plotneishestvo/ZanGei/docs/datasheets/README.md

# Component datasheets

These are unmodified manufacturer documents copied from the project's existing reference collection so the active BBD symbol links do not depend on unpublished notes.

| Local file | Document | Public reference |
|---|---|---|
| [V3208_DATASHEETS.pdf](V3208_DATASHEETS.pdf) | Coolaudio V3208D/V3208SD, V1.1; the build uses the V3208D DIP8 variant | [Supplier reference page](https://cabintechglobal.com/v3208d) |
| [coolaudio-v3205.pdf](coolaudio-v3205.pdf) | Coolaudio V3205SD, V1.0; special spaced eight-lead package | [Public document mirror](https://aionfx.com/app/files/datasheets/coolaudio-v3205.pdf) |

Vendor documents retain their own copyright and notices. The project's MIT declaration does not relicense them or imply manufacturer endorsement. Check applicable redistribution terms before redistributing these documents separately.

Other relevant specifications are linked rather than duplicated:

- [TI CD4046B](https://www.ti.com/product/CD4046B)
- [Microchip TC4428A family](https://www.microchip.com/en-us/product/TC4428A)
- [Nidec CT-6 trimmers](https://www.nidec-components.com/e/catalog/trimmer/ct-6.pdf)
- [Samtec TSW headers](https://suddendocs.samtec.com/catalog_english/tsw_th.pdf) and [SSW sockets](https://suddendocs.samtec.com/catalog_english/ssw_th.pdf)

Select the exact purchased suffix/package; family compatibility does not establish pin numbering or mechanical fit. Use the native schematic and current BOM for the implemented choices.
