plotneishestvo/ZanGei/docs/LICENSING.md

# Licensing

## Project-authored files and hardware designs

The [MIT License](../LICENSE) applies to project-authored schematics, PCB layouts, custom symbols and footprints, mechanical/panel designs and models, scripts, BOM data and documentation, except where a file carries a different notice.

For project-authored hardware designs, permission includes using and modifying the designs to manufacture, use, distribute and sell physical hardware. Retain the applicable copyright and licence notices when distributing the design files or substantial portions of them. The project does not require publication of your modifications.

Copyright notices for the project-authored material include:

- Copyright (c) 2026 Pavel Plotnikov
- Copyright (c) 2026 ZanGei contributors

The standard MIT licence text is retained unchanged in `LICENSE`. This scope statement does not remove any MIT conditions or disclaimers. MIT is not a hardware-specific patent licence, safety certification or guarantee that third-party rights have been cleared.

## Third-party material

The project licence does not relicense third-party material, including:

- Manufacturer datasheets in `docs/datasheets/` and linked documents; see the [datasheet notes](datasheets/README.md).
- The Texas Instruments TL072 SPICE model in `simulation/models/TL072_TI.lib`, which retains its original notices.
- Assets derived from KiCad libraries, which remain subject to their applicable library licence and exceptions.

Respect the notices and terms supplied with each third-party asset. The design is independently developed and inspired by the Erica Synths EDU BBD project; that attribution does not imply endorsement or grant rights to its separate materials.

## Prototype limitations

The supplied design is an unqualified prototype, not a proven kit. Manufacturing, assembly and operation are at the builder's risk. Read the [build and power precautions](BUILD.md); the licence does not replace electrical, mechanical or regulatory assessment.
