plotneishestvo/ZanGei/mechanical/Panel_Front.png

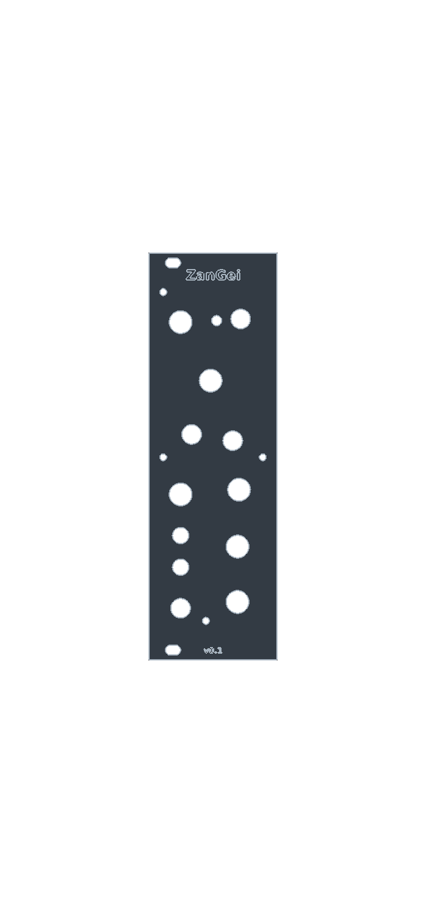
mechanical/Panel_Front.png
