plotneishestvo/ZanGei/mechanical/Panel_Preview.png

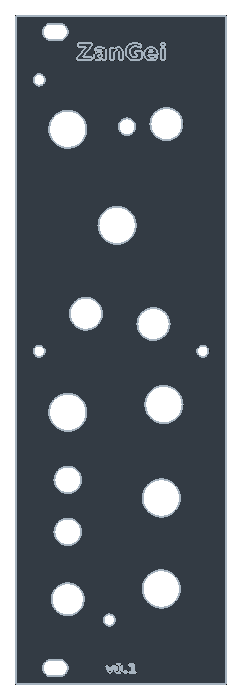
mechanical/Panel_Preview.png
