plotneishestvo/ZanGei/mechanical/Power_Marking.png

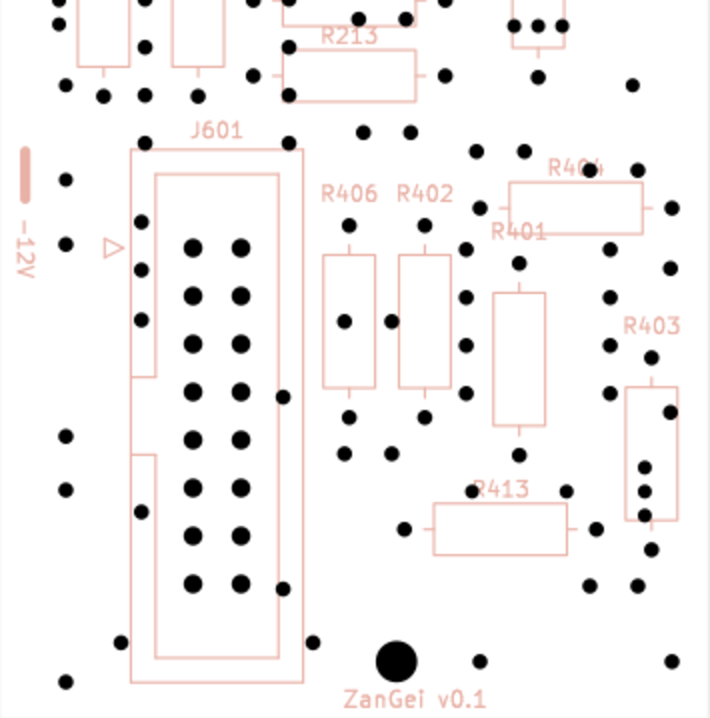
mechanical/Power_Marking.png
