plotneishestvo/ZanGei/schematics/buffer_schematic.png

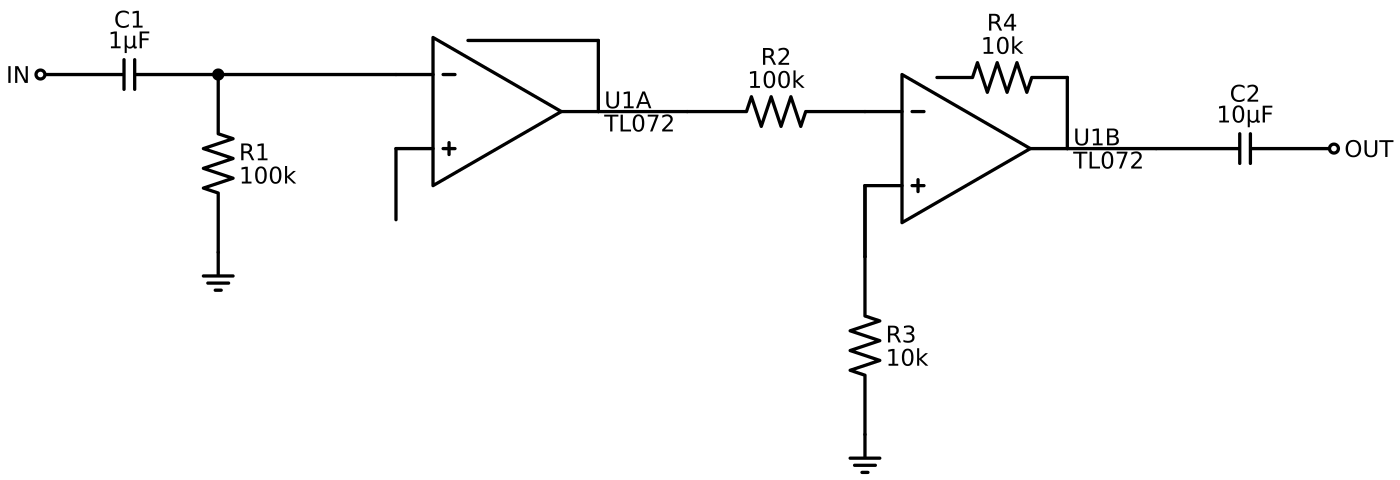
schematics/buffer_schematic.png
