plotneishestvo/ZanGei/schematics/routing/Traces_Review.png

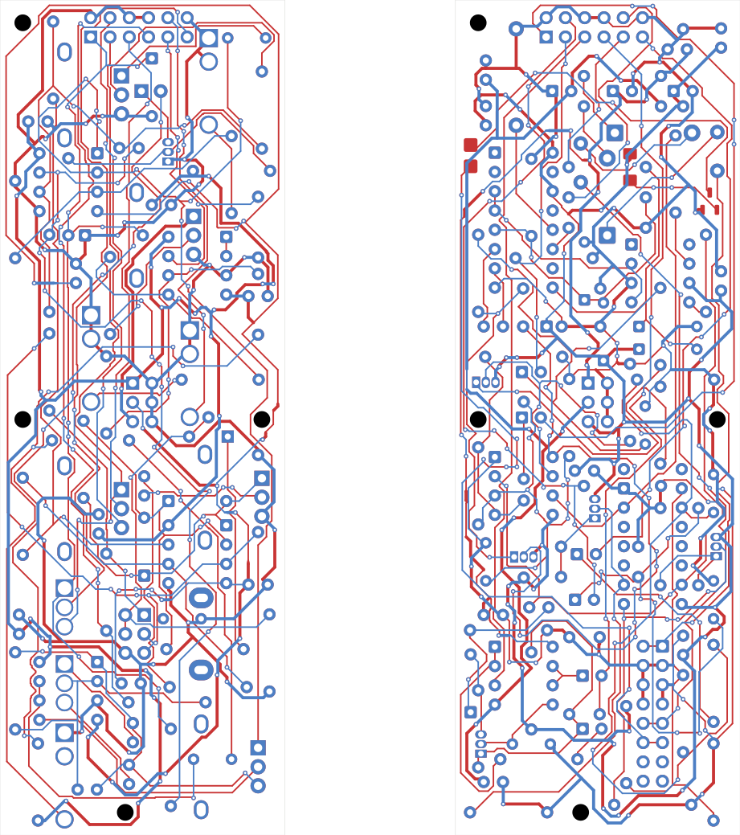
schematics/routing/Traces_Review.png
