plotneishestvo/ZanGei/bom/v0.1/BOM_GROUPED.csv

Group_ID | References | Schematic_values_exact | Quantity_per_module | Selected_part | Footprints | Product_URL | Notes
1N4148 | D401, D402, D403, D702, D703 | 1N4148 ; 1N4148, A at gate | 5 | 1N4148 (= 1N914) | Diode_THT:D_DO-35_SOD27_P7.62mm_Horizontal | https://en.uraltone.com/catalogsearch/result/?q=183-1N4148 | DO-35 axial; observe diode polarity, including D401 anode at gate.
1N5817 | D601, D602 | 1N5817 | 2 | 1N5817 Schottky diode 20V, 1A | Diode_THT:D_DO-41_SOD81_P10.16mm_Horizontal | https://en.uraltone.com/catalogsearch/result/?q=183-1N5817 | 20 V, 1 A Schottky; observe polarity.
2N3904 | Q701 | 2N3904 | 1 | 2N3904BU | Package_TO_SOT_THT:TO-92_Inline | https://www.digikey.com/en/products/detail/onsemi/2N3904BU/1413 | onsemi TO-92; verify received pin order against footprint.
2N5457 | Q401 | 2N5457 S&H switch | 1 | 2N5457 J-FET N-channel Fairchild NOS USA | Package_TO_SOT_THT:TO-92_Inline | https://en.uraltone.com/catalogsearch/result/?q=181-2N5457-FAIR | Selected Fairchild NOS part: physical pins 1=D, 2=S, 3=G; other manufacturers may differ.
2N7000 | Q101, Q102, Q201, Q202 | 2N7000 | 4 | 2N7000 Transistor N-MOSFET, 60V, 200mA, TO-92 | Package_TO_SOT_THT:TO-92_Inline | https://en.uraltone.com/catalogsearch/result/?q=181-2N7000 | 60 V, 200 mA TO-92; verify received pin order.
AO3401A | Q601 | AO3401A | 1 | AO3401A | Package_TO_SOT_SMD:SOT-23-3 | https://www.digikey.com/en/products/detail/alpha-omega-semiconductor-inc/AO3401A/1855773 | P-channel SOT-23; SMD.
BAT85 | D301, D302, D303, D304 | BAT85 | 4 | BAT85S-TAP | Diode_THT:D_DO-34_SOD68_P7.62mm_Horizontal | https://www.digikey.com/en/products/detail/vishay-general-semiconductor-diodes-division/BAT85S-TAP/3104127 | Vishay BAT85S-TAP, 30 V / 200 mA, DO-35; maximum capsule 3.9 x 1.7 mm; P7.62 mm. Body-envelope screening is not full assembly qualification.
CD4046BE | U301 | CD4046BE | 1 | CD4046BE CMOS digital Phase-Locked Loop DIL16 | Package_DIP:DIP-16_W7.62mm_Socket | https://en.uraltone.com/catalogsearch/result/?q=184-4046BE | Through-hole DIL16.
C_10 | C801 | 10p | 1 | C315C100J5G5TA | Zangei:C_Radial_KEMET_C315_P2.54_Body3.81x5.0 | https://www.digikey.com/en/products/detail/kemet/C315C100J5G5TA/6562319 | 10 pF C0G, 5%, 50 V; P2.54 mm.
C_10000 | C405 | 10n | 1 | R82EC2100AA50J | Capacitor_THT:C_Rect_L7.2mm_W2.5mm_P5.00mm | https://www.digikey.com/en/products/detail/kemet/R82EC2100AA50J/2571307 | 10 nF polyester film, 5%, 100 V; P5 mm; nominal body 7.2 x 2.5 mm.
C_100000 | C104, C204, C302, C304, C406, C407, C408, C409, C410, C501, C502, C602, C604, C606, C703, C704, C805, C806 | 100n ; 100nF | 18 | C315C104K5R5TA | Zangei:C_KEMET_C315C104_P2.54_L3.81_W2.54 | https://www.digikey.com/en/products/detail/kemet/C315C104K5R5TA/12701330 | 100 nF X7R, 50 V; compact P2.54 mm body required.
C_1000000 | C701, C804 | 1u film ; 1u film DC BLOCK | 2 | R82EC4100AA70J | Capacitor_THT:C_Rect_L7.2mm_W6.0mm_P5.00mm | https://www.digikey.com/en/products/detail/kemet/R82EC4100AA70J/9685242 | 1 uF polyester film, 5%, 100 V; P5 mm; nominal body 7.2 x 6 mm, seated height 11.1 mm. Do not substitute ceramic.
C_15000 | C403 | 15nF hold | 1 | KEMET 15nF (0.015uF) / 400V polyester film capacitor, radial | Capacitor_THT:C_Rect_L7.2mm_W4.5mm_P5.00mm | https://en.uraltone.com/catalogsearch/result/?q=545-MC5-15N/400V | 15 nF / 400 V polyester film, radial; check actual body and lead seating.
C_220 | C301, C402, C803 | 220p DARK ; 220pF | 3 | C315C221J5G5TA | Zangei:C_Radial_KEMET_C315_P2.54_Body3.81x5.0 | https://www.digikey.com/en/products/detail/kemet/C315C221J5G5TA/6562497 | 220 pF C0G, 5%, 50 V; P2.54 mm.
C_33000 | C102, C202 | 33nF | 2 | R82EC2330AA50J | Capacitor_THT:C_Rect_L7.2mm_W2.5mm_P5.00mm | https://www.digikey.com/en/products/detail/kemet/R82EC2330AA50J/2571333 | 33 nF polyester film, 5%, 100 V; P5 mm; nominal body 7.2 x 2.5 mm.
C_3300000 | C101, C106, C201, C206, C401 | 3.3uF | 5 | Nichicon 3.3uF / 50V FW audio electrolytic capacitor, radial | Capacitor_THT:CP_Radial_D5.0mm_P2.50mm | https://en.uraltone.com/catalogsearch/result/?q=518-003-1H5X11UFW | 3.3 uF / 50 V Nichicon FW; nominal D5 x H11 mm, P2.5 mm; polarised.
C_47 | C702 | 47p | 1 | C315C470J5G5TA | Zangei:C_Radial_KEMET_C315_P2.54_Body3.81x5.0 | https://www.digikey.com/en/products/detail/kemet/C315C470J5G5TA/3725986 | 47 pF C0G, 5%, 50 V; P2.54 mm.
C_4700 | C105, C205 | 4.7nF | 2 | R82EC1470AA50J | Capacitor_THT:C_Rect_L7.2mm_W2.5mm_P5.00mm | https://www.digikey.com/en/products/detail/kemet/R82EC1470AA50J/2571340 | 4.7 nF polyester film, 5%, 100 V; P5 mm; nominal body 7.2 x 2.5 mm.
C_4700000 | C305 | 4.7u 16V | 1 | Panasonic 4.7uF 50V 5x11mm; UralTone518-P-4.7-50 | Zangei:CP_Radial_D5_H11_P2.00_NoModel | https://en.uraltone.com/4-7uf-50v-panasonic-5x11mm-electrolytic-capacitor.html | 4.7 uF / 50 V Panasonic; nominal D5 x H11 mm, P2.0 mm; polarised.
C_47000000 | C404, C601, C603, C607 | 47u / 16V ; 47u / 25V ; 47uF | 4 | Nichicon 47uF / 50V electrolytic capacitor, radial | Capacitor_THT:CP_Radial_D6.3mm_P2.50mm | https://en.uraltone.com/catalogsearch/result/?q=518-047-1H6X11UFW | 47 uF / 50 V Nichicon FW; nominal D6.3 x H11 mm, P2.5 mm; polarised.
C_68 | C802 | 68p SOFT | 1 | C315C680J5G5TA | Zangei:C_Radial_KEMET_C315_P2.54_Body3.81x5.0 | https://www.digikey.com/en/products/detail/kemet/C315C680J5G5TA/12700720 | 68 pF C0G, 5%, 50 V; P2.54 mm.
FERRITE | FB601 | DCR <=0.1R; >=0.5A | 1 | BLM31PG121SN1L | Zangei:Ferrite_Murata_BLM31PG_Pads1.5x1.8_Gap2.0 | https://www.digikey.com/en/products/detail/murata-electronics/BLM31PG121SN1L/584265 | 120 ohm at 100 MHz, DCR <=0.1 ohm, current >=0.5 A; 1206 SMD.
J601 | J601 | EURORACK 2x8 KEYED - BUS +5V | 1 | Exploding Shed 100702 — 2x8 shrouded header | Connector_IDC:IDC-Header_2x08_P2.54mm_Vertical | https://www.exploding-shed.com/2x8-shrouded-header/100702 | Vertical keyed/shrouded 2x8, 2.54 mm; verify actual housing seating, pin 1 and cable polarity.
J602 | J602 | CORE POWER | 1 | Samtec TSW-120-15-G-D cut to 2x3 | Connector_PinHeader_2.54mm:PinHeader_2x03_P2.54mm_Vertical | https://www.digikey.com/en/products/detail/samtec-inc/TSW-120-15-G-D/2686005 | One 2x3 section cut from ONE shared 2x20 TSW-120-15-G-D strip per module; that same strip also supplies J604. Keep 13.21 mm mating posts intact.
J603 | J603 | CONTROL POWER | 1 | SSW-103-01-G-D | Connector_PinSocket_2.54mm:PinSocket_2x03_P2.54mm_Vertical | https://www.digikey.com/en/products/detail/samtec-inc/SSW-103-01-G-D/1112055 | 2x3, 2.54 mm; 8.51 mm socket body. Mate with J602; dry-fit at 20 mm PCB-surface gap.
J604 | J604 | CORE SIGNALS | 1 | Samtec TSW-120-15-G-D cut to 2x6 | Connector_PinHeader_2.54mm:PinHeader_2x06_P2.54mm_Vertical | https://www.digikey.com/en/products/detail/samtec-inc/TSW-120-15-G-D/2686005 | One 2x6 section from the SAME 2x20 strip as J602; no second full strip required. Keep 13.21 mm mating posts intact.
J605 | J605 | CONTROL SIGNALS | 1 | SSW-106-01-G-D | Connector_PinSocket_2.54mm:PinSocket_2x06_P2.54mm_Vertical | https://www.digikey.com/en/products/detail/samtec-inc/SSW-106-01-G-D/1112052 | 2x6, 2.54 mm; 8.51 mm socket body. Mate with J604; dry-fit at 20 mm PCB-surface gap.
JACK | J301, J302, J701, J702 | AUDIO IN ; AUDIO OUT ; INHIBIT CV ; TIME CV | 4 | Qingpu WQP518MA, Exploding Shed 100515 | Zangei:Jack_WQP518MA_PJ398SM_Numeric | https://www.exploding-shed.com/thonkiconn-mono-wqp518ma/100515 | Vertical switched mono PCB jack; effective body height 10 mm, M6x0.5 thread; four separate nuts required. Not WQP518MA-BM.
LED | D701 | RED CLIP | 1 | WP3A8ID | LED_THT:LED_D3.0mm | https://www.digikey.com/en/products/detail/kingbright/WP3A8ID/1747618 | Red diffused 3 mm LED; set panel height before trimming leads.
PTC_RADIAL | F601, F602 | 200mA HOLD, >=30V | 2 | MF-R020-2 | Zangei:PTC_Bourns_MF-R020_P5.10 | https://www.digikey.com/en/products/detail/bourns-inc/MF-R020-2/2561642 | 200 mA hold / 400 mA trip, 60 V radial PTC; D7.4 x T3.1 mm, P5.1 mm, maximum seated height 12.7 mm. Hold current is not an instantaneous limit.
PTC_SMD | F603 | 1206L025/24 250mA HOLD | 1 | 1206L025/24YR | Zangei:PTC_Littelfuse_1206L_ManufacturerLands | https://www.digikey.com/en/products/detail/littelfuse-inc/1206L025-24YR/14320017 | 250 mA hold, 24 V; 1206 SMD with selected Littelfuse land pattern.
RV_DUAL50K | RV402 | 2x50k LIN CHARACTER | 1 | Alpha RD902F dual B50K, SKU100895-B50K | Potentiometer_THT:Potentiometer_Alpha_RD902F-40-00D_Dual_Vertical | https://www.exploding-shed.com/alpha-rd902f-dual-vertical/100895-B50K | Dual linear 50k, 6.35 mm round shaft; exact variant seating/drill fit requires comparison. R414/R415 are exact 50k shunts.
RV_SINGLE10000 | RV404, RV801 | 10k LIN AMOUNT ; 10k LIN DRY / WET | 2 | UT RD901F B10K T18 shaft,624-UT-RD901F-40-15K-B10K | Zangei:Potentiometer_RV09_ExplodingShed_101018 | https://en.uraltone.com/ut-rd901f-40-15k-series-10k-lin-9mm-vertical-potentiometer.html | Single linear 10k; 6 mm T18 knurled shaft. Drawing shows 2.5 mm pitch versus catalogue 2.54 mm; dry-fit common panel plane.
RV_SINGLE100000 | RV301, RV401, RV701 | 100k LIN INPUT ; 100k LIN wet blend (provisional) ; 100k TIME LIN | 3 | RV9 B100K linear D-shaft, SKU101018-B100K | Zangei:Potentiometer_RV09_ExplodingShed_101018 | https://www.exploding-shed.com/b100k-potentiometer-rv9-d-shaft/101018-B100K | Single linear 100k; 6 mm D shaft; includes nut/washer. Verify common panel seating.
RV_TRIM10K | RV403 | 10k DRIVE TRIM | 1 | CT-6EP103 | Zangei:Trimmer_Nidec_CT-6EP | https://www.digikey.fi/en/products/detail/nidec-components/CT-6EP103/738304 | Nidec 10k top-adjust cermet; 2.5 mm triangular pitch; nominal 7 x 7 x 5.8 mm, reserved envelope 7.3 x 7.3 x 6.1 mm.
R_100 | R413, R708 | 100 ; 100R | 2 | 100 ohm metal-film 0.25W <=1%, axial | Zangei:R_Axial_L6.8mm_D2.5mm_P10.16mm |  | Axial metal-film, 0.25 W, <=1%; body <=6.8 x 2.5 mm; form leads to P10.16 mm.
R_1000 | R101, R201, R603, R701, R716, R804 | 1k ; 1k / 0.125W BLEED ; 1k OUTPUT ISOLATION | 6 | 1000 ohm metal-film 0.25W <=1%, axial | Zangei:R_Axial_L6.8mm_D2.5mm_P10.16mm |  | Axial metal-film, 0.25 W, <=1%; body <=6.8 x 2.5 mm; form leads to P10.16 mm.
R_10000 | R110, R111, R112, R113, R210, R211, R212, R213, R715 | 10k ; 10k LED | 9 | 10000 ohm metal-film 0.25W <=1%, axial | Zangei:R_Axial_L6.8mm_D2.5mm_P10.16mm |  | Axial metal-film, 0.25 W, <=1%; body <=6.8 x 2.5 mm; form leads to P10.16 mm.
R_100000 | R102, R114, R202, R214, R304, R306, R401, R402, R403, R406, R411, R501, R705, R805 | 100k ; 100k LOOP RANGE | 14 | MFR-25FBF52-100K | Zangei:R_Axial_L6.8mm_D2.5mm_P10.16mm | https://www.digikey.com/en/products/detail/yageo/MFR-25FBF52-100K/13473 | Exact 100000 ohm, 1%; axial P10.16 mm. Preserve selected part and verify its rated power/body against manufacturer data.
R_1000000 | R305, R408, R704, R707 | 1M ; 1M INPUT BIAS | 4 | 1000000 ohm metal-film 0.25W <=1%, axial | Zangei:R_Axial_L6.8mm_D2.5mm_P10.16mm |  | Axial metal-film, 0.25 W, <=1%; body <=6.8 x 2.5 mm; form leads to P10.16 mm.
R_1200 | R407 | 1k2 | 1 | MFR-25FTE52-1K2 | Zangei:R_Axial_L6.8mm_D2.5mm_P10.16mm | https://www.digikey.com/en/products/detail/yageo/MFR-25FTE52-1K2/9139850 | Exact 1200 ohm, 1%; axial P10.16 mm. Preserve selected part and verify its rated power/body against manufacturer data.
R_120000 | R103, R203 | 120k | 2 | MFR-25FBF52-120K | Zangei:R_Axial_L6.8mm_D2.5mm_P10.16mm | https://www.digikey.com/en/products/detail/yageo/MFR-25FBF52-120K/9138049 | Exact 120000 ohm, 1%; axial P10.16 mm. Preserve selected part and verify its rated power/body against manufacturer data.
R_20000 | R503, R801 | 20k | 2 | 20000 ohm metal-film 0.25W <=1%, axial | Zangei:R_Axial_L6.8mm_D2.5mm_P10.16mm |  | Axial metal-film, 0.25 W, <=1%; body <=6.8 x 2.5 mm; form leads to P10.16 mm.
R_200000 | R502 | 200k | 1 | MFR-25FBF52-200K | Zangei:R_Axial_L6.8mm_D2.5mm_P10.16mm | https://www.digikey.com/en/products/detail/yageo/MFR-25FBF52-200K/13547 | Exact 200000 ohm, 1%; axial P10.16 mm. Preserve selected part and verify its rated power/body against manufacturer data.
R_2200 | R409 | 2k2 | 1 | 2200 ohm metal-film 0.25W <=1%, axial | Zangei:R_Axial_L6.8mm_D2.5mm_P10.16mm |  | Axial metal-film, 0.25 W, <=1%; body <=6.8 x 2.5 mm; form leads to P10.16 mm.
R_22000 | R410 | 22k | 1 | MFR-25FBF52-22K | Zangei:R_Axial_L6.8mm_D2.5mm_P10.16mm | https://www.digikey.com/en/products/detail/yageo/MFR-25FBF52-22K/9138098 | Exact 22000 ohm, 1%; axial P10.16 mm. Preserve selected part and verify its rated power/body against manufacturer data.
R_2200000 | R302 | 2.2M | 1 | carbon composition 2.2 Mohm | Zangei:R_Axial_L9.25mm_D3.6mm_P12.70mm | https://en.uraltone.com/catalogsearch/result/?q=661-2M2 | 2.2 Mohm carbon composition, supplier SKU 661-2M2; tolerance and power rating not recorded in source BOM: confirm before selection. Dedicated P12.70 mm footprint; body envelope 9.25 x 3.6 mm.
R_300000 | R412 | 300k LOOP CAL | 1 | 300000 ohm metal-film 0.25W <=1%, axial | Zangei:R_Axial_L6.8mm_D2.5mm_P10.16mm |  | Axial metal-film, 0.25 W, <=1%; body <=6.8 x 2.5 mm; form leads to P10.16 mm.
R_39000 | R301 | 39k | 1 | MFR50SFTE52-39K | Zangei:R_Axial_L6.8mm_D2.5mm_P10.16mm | https://www.digikey.com/en/products/detail/yageo/MFR50SFTE52-39K/9151453 | Exact 39000 ohm, 1%; axial P10.16 mm. Preserve selected part and verify its rated power/body against manufacturer data.
R_4.7 | R314, R315 | 4R7 1% | 2 | MFR50SFTE52-4R7 | Zangei:R_Axial_L6.8mm_D2.5mm_P10.16mm | https://www.digikey.com/en/products/detail/yageo/MFR50SFTE52-4R7/9151582 | Exact 4.7 ohm, 1%; axial P10.16 mm. Preserve selected part and verify its rated power/body against manufacturer data.
R_40000 | R504 | 40k | 1 | CMF5540K000BHEB | Zangei:R_Axial_L6.8mm_D2.5mm_P10.16mm | https://www.digikey.com/en/products/detail/vishay-dale/CMF5540K000BHEB/3634122 | Exact 40000 ohm, 0.1%; axial P10.16 mm. Preserve selected part and verify its rated power/body against manufacturer data.
R_4700 | R106, R206, R404 | 4k7 | 3 | 4700 ohm metal-film 0.25W <=1%, axial | Zangei:R_Axial_L6.8mm_D2.5mm_P10.16mm |  | Axial metal-film, 0.25 W, <=1%; body <=6.8 x 2.5 mm; form leads to P10.16 mm.
R_47000 | R706 | 47k | 1 | 47000 ohm metal-film 0.25W <=1%, axial | Zangei:R_Axial_L6.8mm_D2.5mm_P10.16mm |  | Axial metal-film, 0.25 W, <=1%; body <=6.8 x 2.5 mm; form leads to P10.16 mm.
R_470000 | R802 | 470k WET RECOVERY | 1 | 470000 ohm metal-film 0.25W <=1%, axial | Zangei:R_Axial_L6.8mm_D2.5mm_P10.16mm |  | Axial metal-film, 0.25 W, <=1%; body <=6.8 x 2.5 mm; form leads to P10.16 mm.
R_50000 | R414, R415 | 50k 1% | 2 | MFP50SBBE52-50K | Zangei:R_Axial_L6.8mm_D2.5mm_P10.16mm | https://www.digikey.com/en/products/detail/yageo/MFP50SBBE52-50K/9127584 | Exact 50000 ohm, 0.1%; axial P10.16 mm. Preserve selected part and verify its rated power/body against manufacturer data.
R_51000 | R108, R109, R208, R209 | 51k | 4 | 51000 ohm metal-film 0.25W <=1%, axial | Zangei:R_Axial_L6.8mm_D2.5mm_P10.16mm |  | Axial metal-film, 0.25 W, <=1%; body <=6.8 x 2.5 mm; form leads to P10.16 mm.
R_68000 | R107, R207, R717 | 68k ; 68k LED BIAS | 3 | 68000 ohm metal-film 0.25W <=1%, axial | Zangei:R_Axial_L6.8mm_D2.5mm_P10.16mm |  | Axial metal-film, 0.25 W, <=1%; body <=6.8 x 2.5 mm; form leads to P10.16 mm.
R_FLAMEPROOF_10 | R601, R602 | 10R flameproof 0.5W | 2 | NFR25H0001009JA500 | Zangei:R_Axial_L6.8mm_D2.5mm_P10.16mm | https://www.digikey.com/en/products/detail/vishay-beyschlag-draloric-bc-components/NFR25H0001009JA500/7350581 | 10 ohm, 0.5 W, 5%, Vishay NFR25H flameproof/fusible. Maximum coated body 7.5 x 2.5 mm. Generic metal-film parts are not safety-equivalent.
SW201 | SW201 | PARALLEL / SERIES | 1 | Salecom SKS04SP, SKU100060 | Zangei:Switch_Salecom_SKS_SP_Straight | https://www.exploding-shed.com/salecom-sks04sp-sub-mini-spdt-on-on-pc/100060 | SPDT ON-ON; straight PCB terminals.
SW801 | SW801 | ON-OFF-ON: SOFT / OFF / DARK | 1 | Salecom SKS07SP, SKU100061 | Zangei:Switch_Salecom_SKS_SP_Straight | https://www.exploding-shed.com/salecom-sks07sp-sub-mini-spdt-on-off-on-pc/100061 | SPDT ON-OFF-ON; straight PCB terminals. Check SKU and positions despite inconsistent seller prose.
TC4428AEPA | U304 | TC4428AEPA | 1 | TC4428AEPA | Package_DIP:DIP-8_W7.62mm_Socket | https://www.digikey.com/en/products/detail/microchip-technology/TC4428AEPA/442809 | Exact A-version complementary inverting/non-inverting driver; through-hole PDIP8, not SOIC/MSOP.
TL072 | U302, U401, U402, U701, U702 | TL072 | 5 | TL072ACP - op amp -Texas instruments | Package_DIP:DIP-8_W7.62mm_Socket | https://en.uraltone.com/catalogsearch/result/?q=184-TL072ACP | Texas Instruments TL072ACP, DIP8; not an automatic NE5532 substitution.
V3205SD | U201 | V3205SD | 1 | Coolaudio V3205SD special spaced 8-lead BBD | Zangei:V3205SD_DIP16_Socket_LogicalPads | https://www.op-electronics.com/en/delay-chips/95-coolaudio-v3205sd.html | Special spaced eight-lead package in selected holes of a 16-position socket pattern; NOT ordinary consecutive-pin DIP8.
V3208D | U101 | V3208D | 1 | Coolaudio V3208D 2048-Stage Low-Noise BBD Analog Delay Line IC (DIP8) | Package_DIP:DIP-8_W7.62mm_Socket | https://en.uraltone.com/catalogsearch/result/?q=184S-V3208D | Coolaudio 2048-stage BBD, DIP8; distinct from U201 V3205SD.
