plotneishestvo/ZanGei/mechanical/ZanGei_v0.1_Panel_PRINT_FACE_DOWN.stl

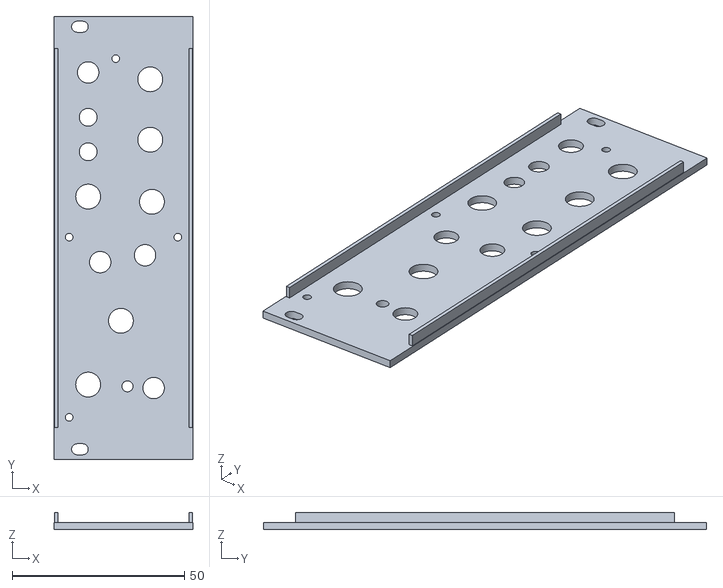
[picture p8: CAD file, 2026-11-02]
mechanical/ZanGei_v0.1_Panel_PRINT_FACE_DOWN.stl
40.3 x 128.5 x 5.00
