plotneishestvo/ZanGei/(list of files, cad)

Other CAD files:
mechanical/ZanGei_v0.1_Panel.step
mechanical/ZanGei_v0.1_Panel.FCStd
