plotneishestvo/ZanGei/schematics/BBD_Buffer.kicad_pcb

## KiCad design schematics/BBD_Buffer.kicad_pcb (2026-11-02)

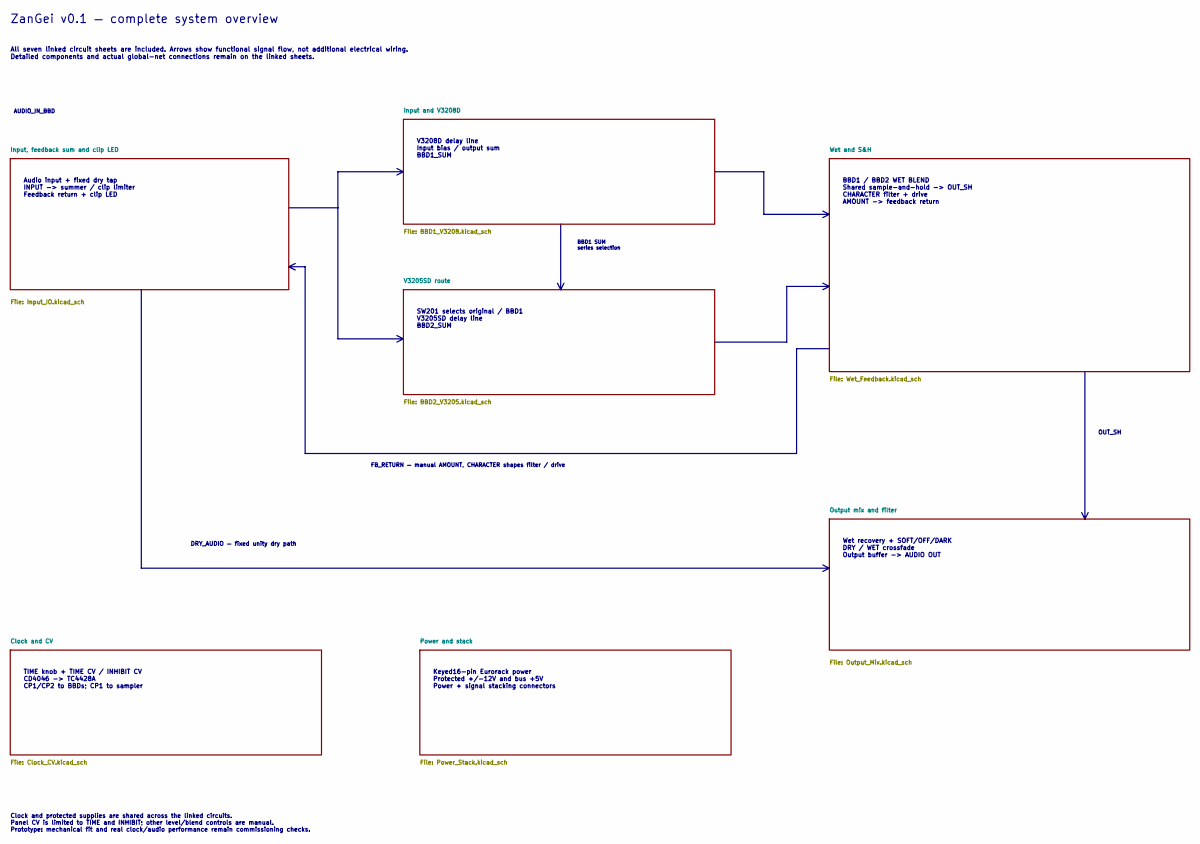
[picture p9: schematic BBD_Buffer.kicad_sch]

Notes on the sheet:
V3208D delay line Input bias / output sum BBD1_SUM
Wet recovery + SOFT/OFF/DARK DRY / WET crossfade Output buffer -> AUDIO OUT
BBD1 / BBD2 WET BLEND Shared sample-and-hold -> OUT_SH CHARACTER filter + drive AMOUNT -> feedback return
Audio input + fixed dry tap INPUT -> summer / clip limiter Feedback return + clip LED
TIME knob + TIME CV / INHIBIT CV CD4046 -> TC4428A CP1/CP2 to BBDs; CP1 to sampler
Keyed16-pin Eurorack power Protected +/-12V and bus +5V Power + signal stacking connectors
SW201 selects original / BBD1 V3205SD delay line BBD2_SUM
ZanGei v0.1 — complete system overview
All seven linked circuit sheets are included. Arrows show functional signal flow, not additional electrical wiring. Detailed components and actual global-net connections remain on the linked sheets.
AUDIO_IN_BBD
BBD1 SUM series selection
FB_RETURN — manual AMOUNT, CHARACTER shapes filter / drive
DRY_AUDIO — fixed unity dry path
OUT_SH
Clock and protected supplies are shared across the linked circuits. Panel CV is limited to TIME and INHIBIT; other level/blend controls are manual. Prototype: mechanical fit and real clock/audio performance remain commissioning checks.

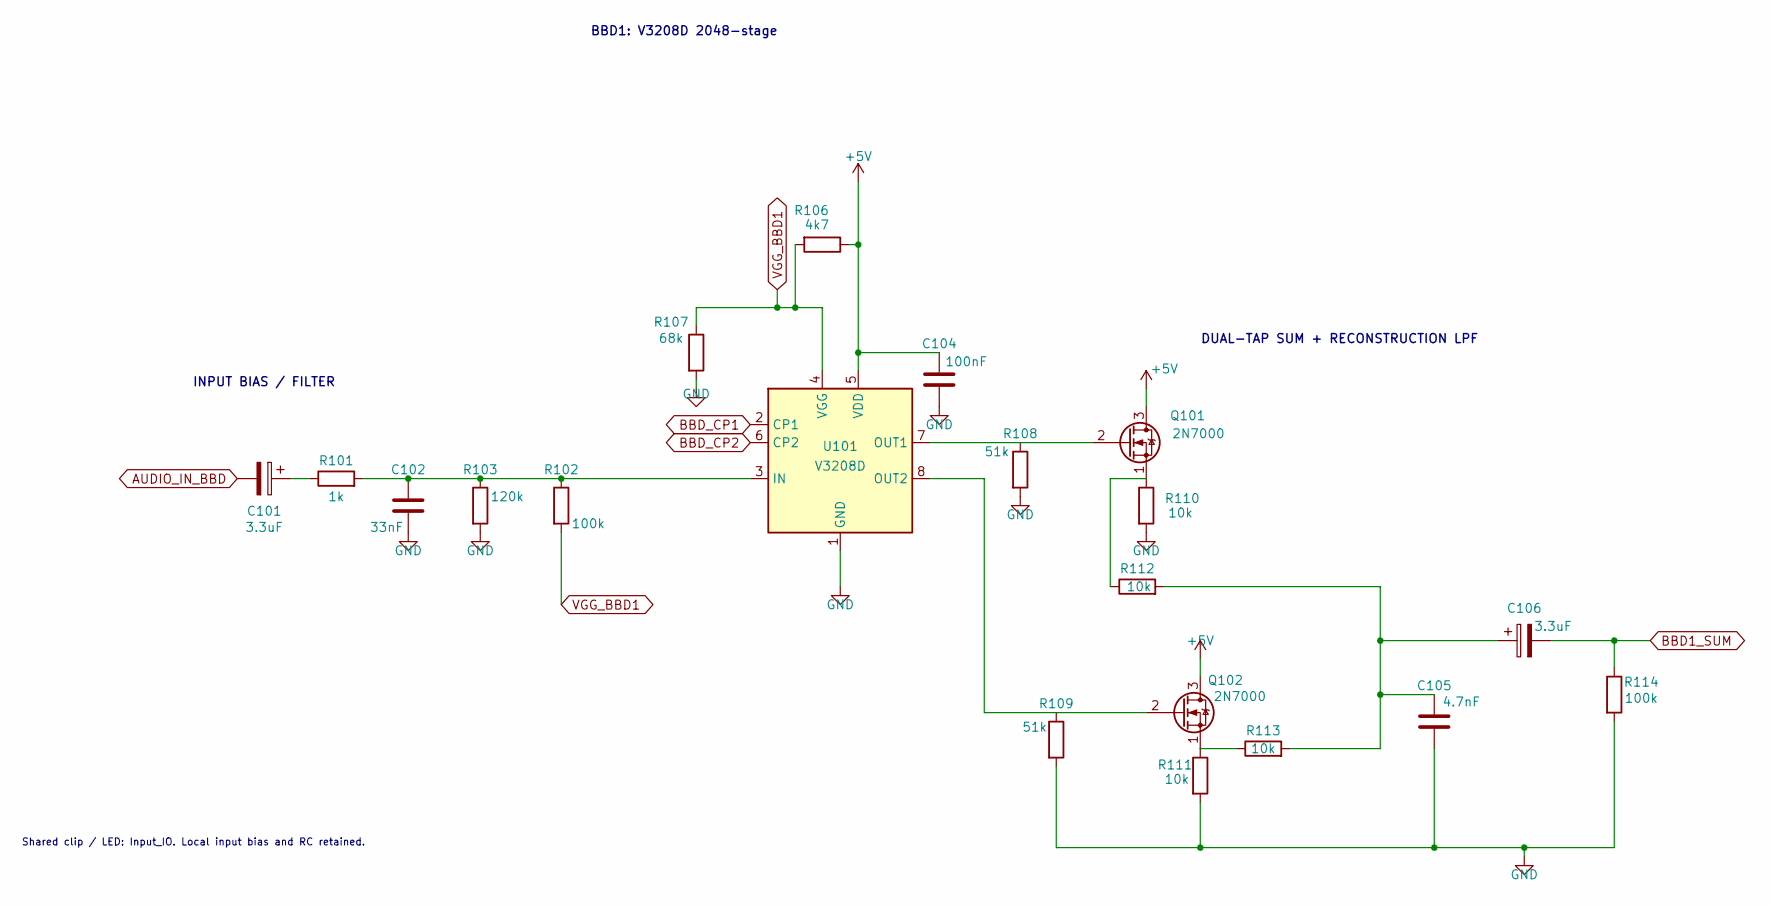
[picture p10: schematic BBD1_V3208.kicad_sch, Zangei BBD1 V3208D]

Parts:
C101, C106: 3.3uF; CP_Radial_D5.0mm_P2.50mm
C102: 33nF; C_Rect_L7.2mm_W2.5mm_P5.00mm
C104: 100nF; C_KEMET_C315C104_P2.54_L3.81_W2.54; MPN C315C104K5R5TA
C105: 4.7nF; C_Rect_L7.2mm_W2.5mm_P5.00mm
Q101, Q102: 2N7000; TO-92_Inline
R101: 1k; R_Axial_L6.8mm_D2.5mm_P10.16mm
R102, R114: 100k; R_Axial_L6.8mm_D2.5mm_P10.16mm
R103: 120k; R_Axial_L6.8mm_D2.5mm_P10.16mm
R106: 4k7; R_Axial_L6.8mm_D2.5mm_P10.16mm
R107: 68k; R_Axial_L6.8mm_D2.5mm_P10.16mm
R108, R109: 51k; R_Axial_L6.8mm_D2.5mm_P10.16mm
R110, R111, R112, R113: 10k; R_Axial_L6.8mm_D2.5mm_P10.16mm
U101: V3208D; DIP-8_W7.62mm_Socket

Connections:
+5V: C104.1, Q101.3 (D), Q102.3 (D), R106.1, U101.5 (VDD); also elsewhere on the board
AUDIO_IN_BBD: C101.2; also elsewhere on the board
BBD1_SUM: C106.2, R114.1; also elsewhere on the board
BBD_CP1: U101.2 (CP1); also elsewhere on the board
BBD_CP2: U101.6 (CP2); also elsewhere on the board
GND: C102.2, C104.2, C105.2, R103.2, R107.2, R108.2, R109.2, R110.2, R111.2, R114.2, U101.1 (GND); also elsewhere on the board
unnamed: C101.1, R101.1
unnamed: C105.1, C106.1, R112.2, R113.2
unnamed: Q101.2 (G), R108.1, U101.7 (OUT1)
unnamed: Q101.1 (S), R110.1, R112.1
unnamed: Q102.2 (G), R109.1, U101.8 (OUT2)
unnamed: Q102.1 (S), R111.1, R113.1
unnamed: C102.1, R101.2, R102.1, R103.1, U101.3 (IN)
VGG_BBD1: R102.2, R106.2, R107.1, U101.4 (VGG)

Notes on the sheet:
INPUT BIAS / FILTER
Shared clip / LED: Input_IO. Local input bias and RC retained.
BBD1: V3208D 2048-stage
DUAL-TAP SUM + RECONSTRUCTION LPF

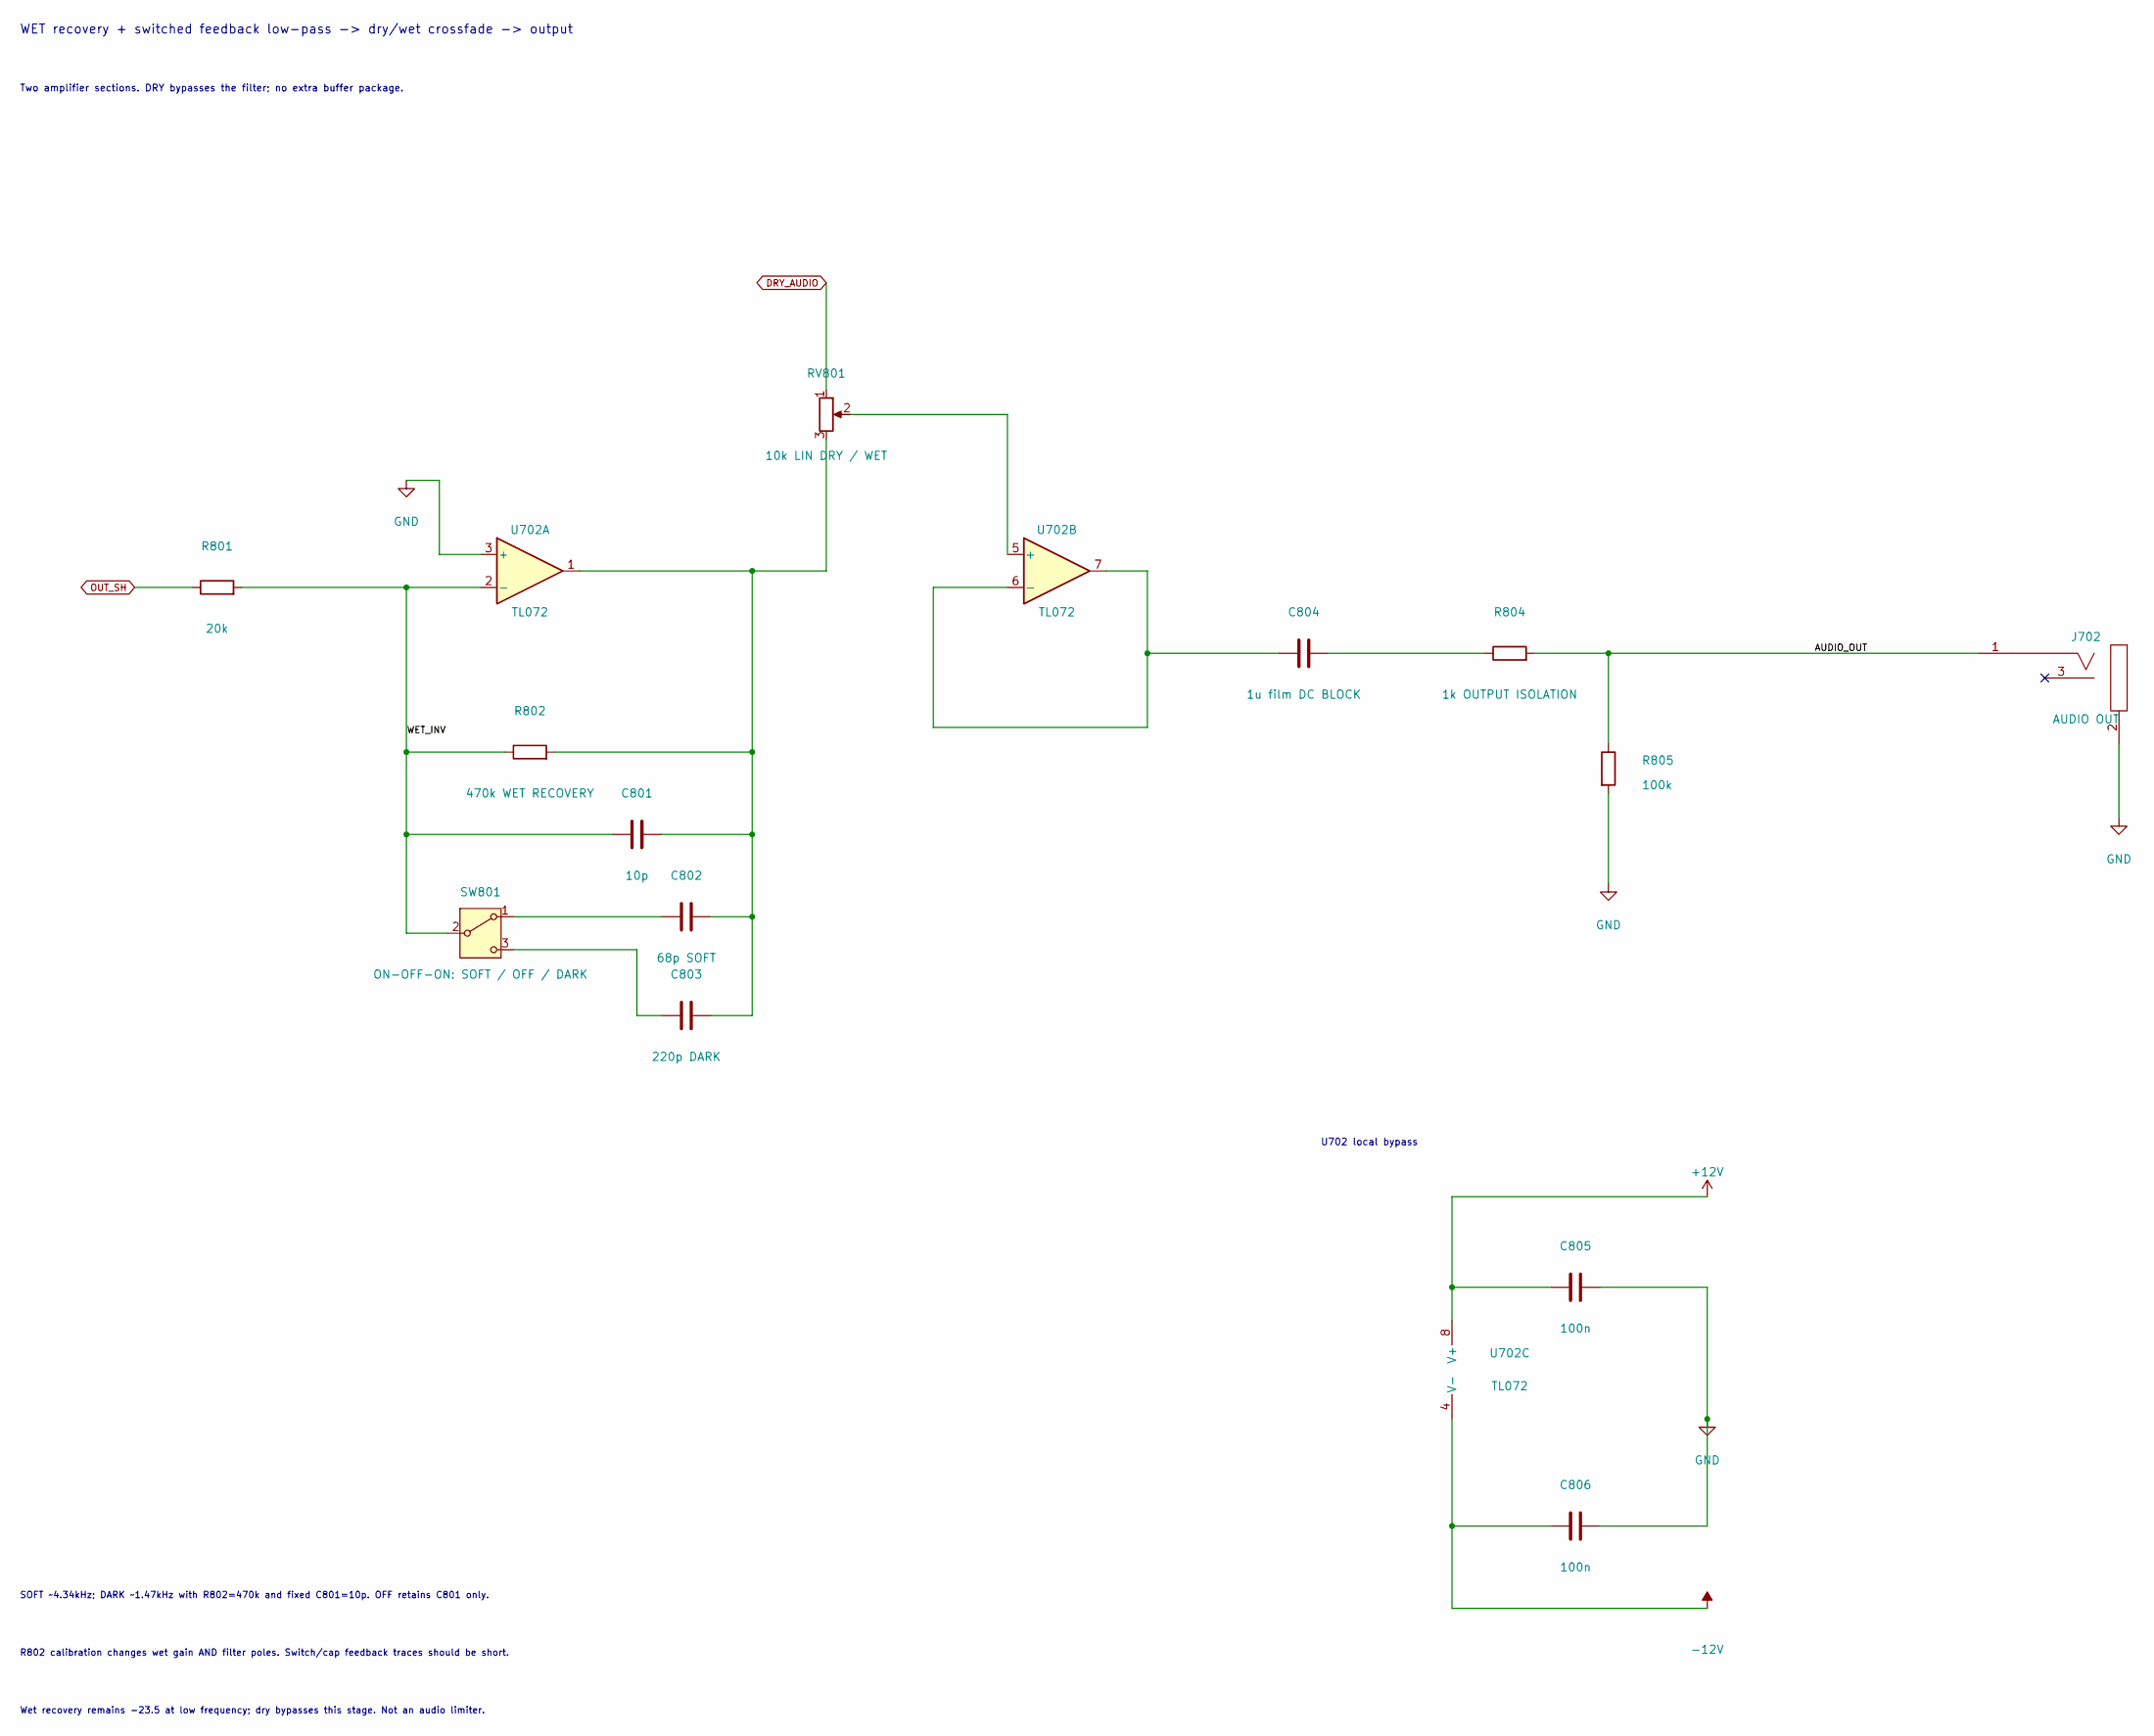
[picture p11: schematic Output_Mix.kicad_sch, ZanGei - wet-only filter, crossfade and output]

Parts:
C801: 10p; C_Radial_KEMET_C315_P2.54_Body3.81x5.0
C802: 68p SOFT; C_Radial_KEMET_C315_P2.54_Body3.81x5.0
C803: 220p DARK; C_Radial_KEMET_C315_P2.54_Body3.81x5.0
C804: 1u film DC BLOCK; C_Rect_L7.2mm_W6.0mm_P5.00mm
C805, C806: 100n; C_KEMET_C315C104_P2.54_L3.81_W2.54; MPN C315C104K5R5TA
J702: AUDIO OUT; Jack_WQP518MA_PJ398SM_Numeric
R801: 20k; R_Axial_L6.8mm_D2.5mm_P10.16mm
R802: 470k WET RECOVERY; R_Axial_L6.8mm_D2.5mm_P10.16mm
R804: 1k OUTPUT ISOLATION; R_Axial_L6.8mm_D2.5mm_P10.16mm
R805: 100k; R_Axial_L6.8mm_D2.5mm_P10.16mm
RV801: 10k LIN DRY / WET; Potentiometer_RV09_ExplodingShed_101018
SW801: ON-OFF-ON: SOFT / OFF / DARK; Switch_Salecom_SKS_SP_Straight
U702: TL072; DIP-8_W7.62mm_Socket

Connections:
+12V: C805.1, U702.8 (V+); also elsewhere on the board
-12V: C806.1, U702.4 (V-); also elsewhere on the board
/Output mix and filter/AUDIO_OUT: J702.1 (SIG), R804.2, R805.1
/Output mix and filter/WET_INV: C801.1, R801.2, R802.1, SW801.2 (B), U702.2 (-)
DRY_AUDIO: RV801.1; also elsewhere on the board
GND: C805.2, C806.2, J702.2 (SHEILD), R805.2, U702.3 (+); also elsewhere on the board
unnamed: C801.2, C802.2, C803.2, R802.2, RV801.3, U702.1
unnamed: C804.2, R804.1
unnamed: C802.1, SW801.1 (A)
unnamed: C803.1, SW801.3 (C)
unnamed: RV801.2, U702.5 (+)
unnamed: C804.1, U702.6 (-), U702.7
OUT_SH: R801.1; also elsewhere on the board

Notes on the sheet:
R802 calibration changes wet gain AND filter poles. Switch/cap feedback traces should be short.
U702 local bypass
Two amplifier sections. DRY bypasses the filter; no extra buffer package.
SOFT ~4.34kHz; DARK ~1.47kHz with R802=470k and fixed C801=10p. OFF retains C801 only.
WET recovery + switched feedback low-pass -> dry/wet crossfade -> output
Wet recovery remains -23.5 at low frequency; dry bypasses this stage. Not an audio limiter.

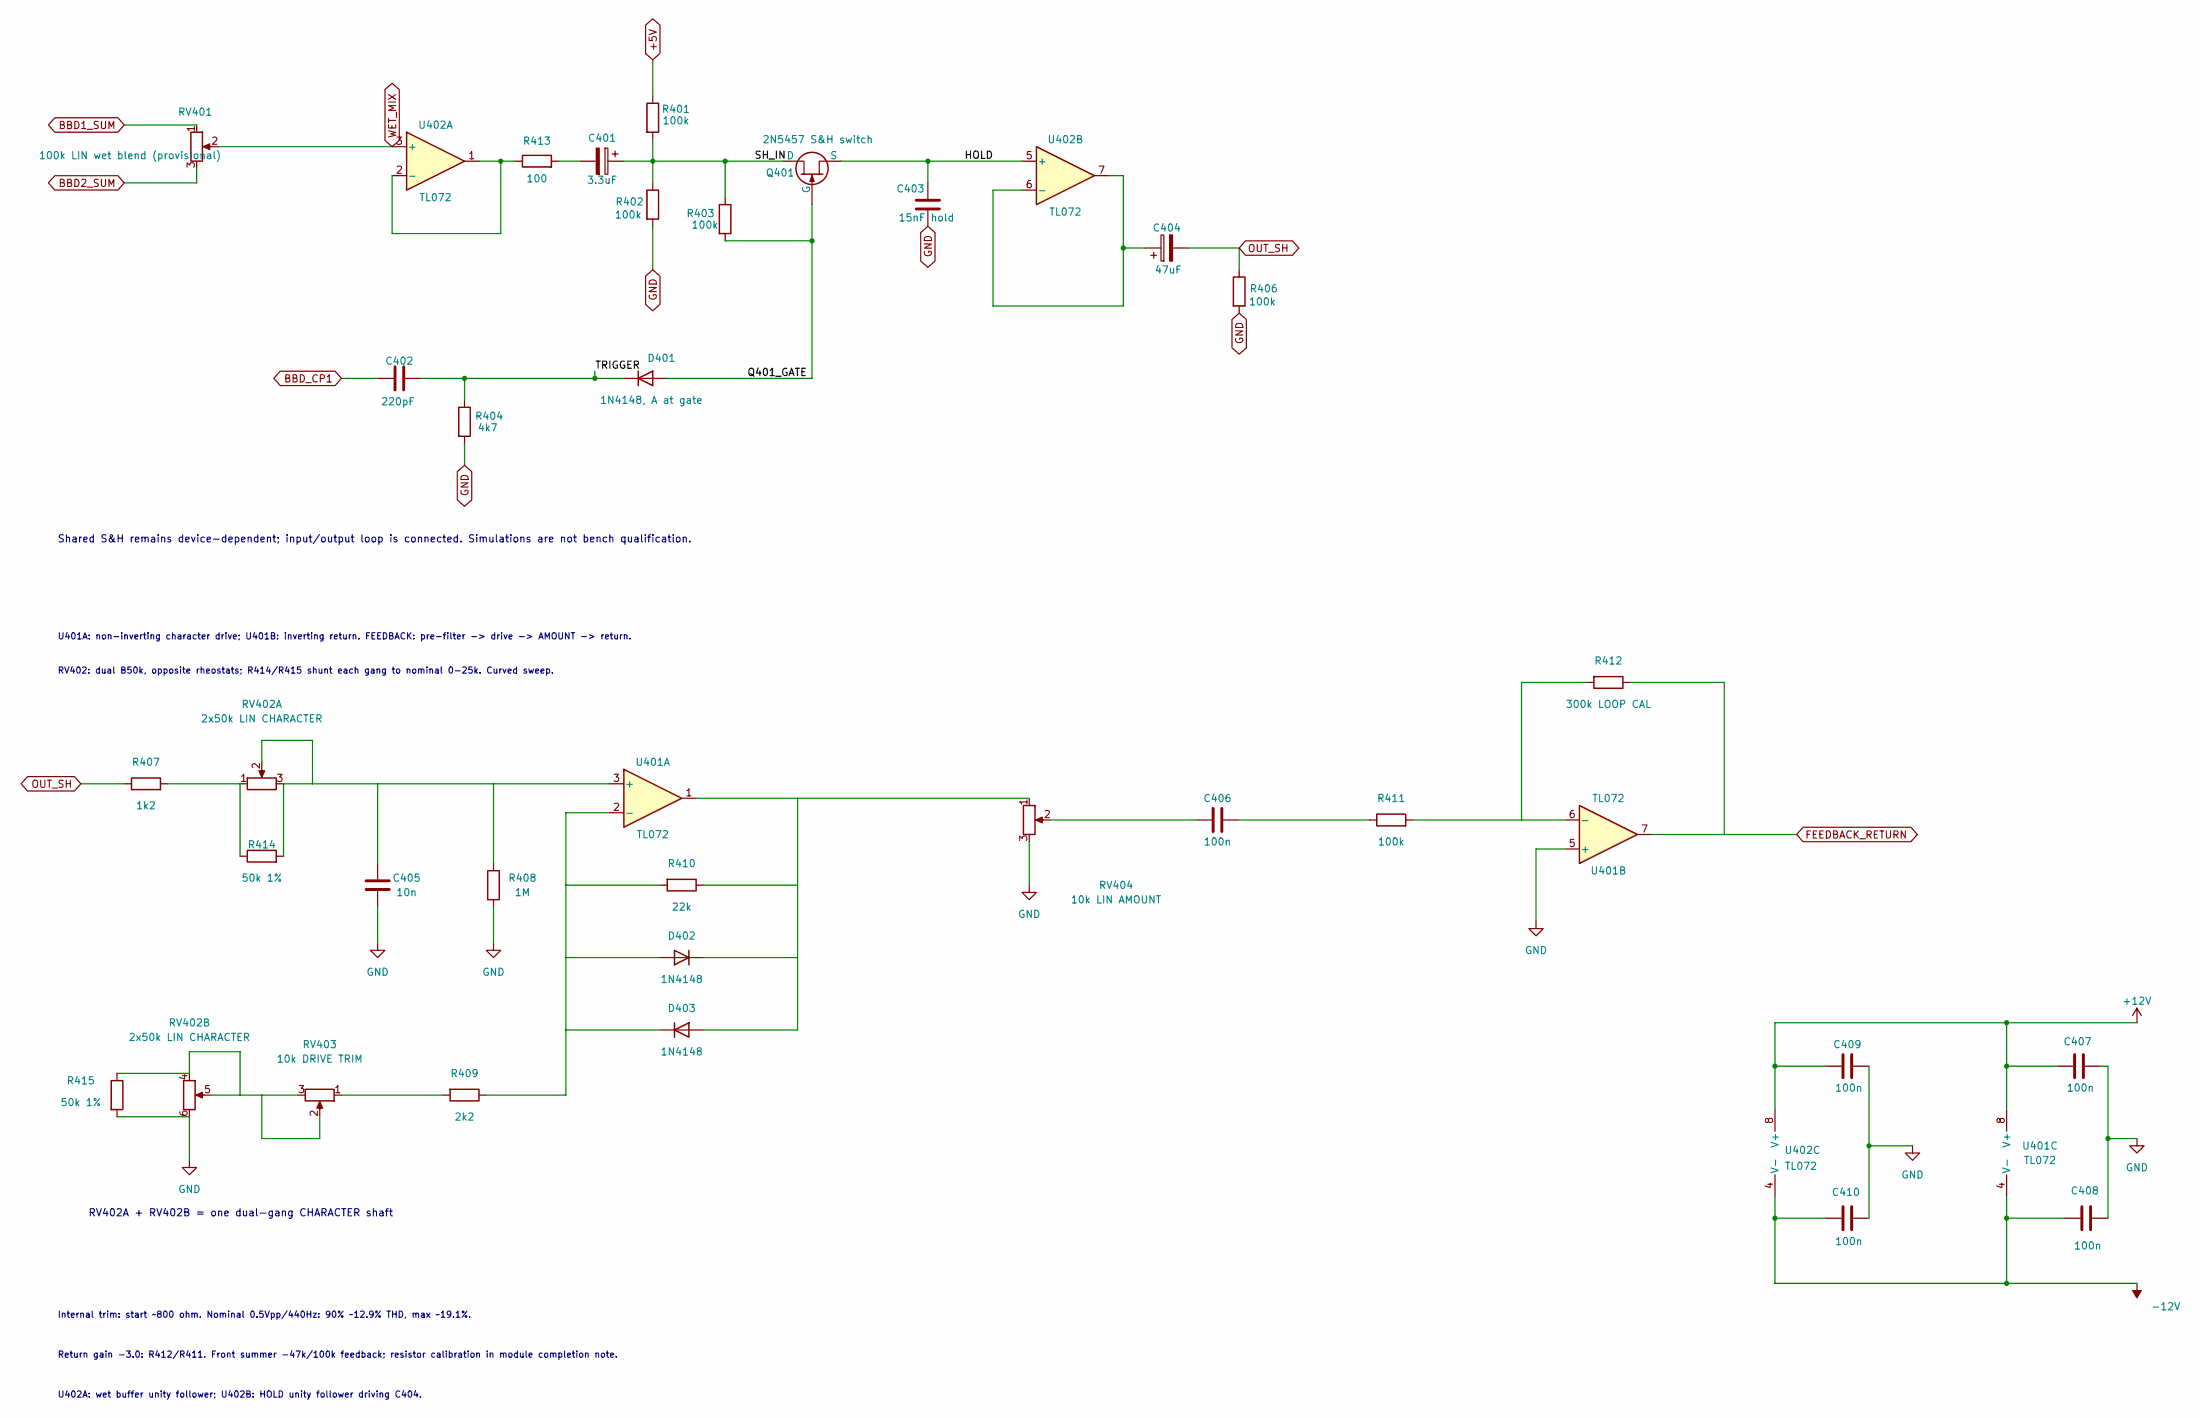
[picture p12: schematic Wet_Feedback.kicad_sch]

Parts:
C401: 3.3uF; CP_Radial_D5.0mm_P2.50mm
C402: 220pF; C_Radial_KEMET_C315_P2.54_Body3.81x5.0
C403: 15nF hold; C_Rect_L7.2mm_W4.5mm_P5.00mm
C404: 47uF; CP_Radial_D6.3mm_P2.50mm
C405: 10n; C_Rect_L7.2mm_W2.5mm_P5.00mm
C406, C407, C408, C409, C410: 100n; C_KEMET_C315C104_P2.54_L3.81_W2.54; MPN C315C104K5R5TA
D401: 1N4148, A at gate; D_DO-35_SOD27_P7.62mm_Horizontal
D402, D403: 1N4148; D_DO-35_SOD27_P7.62mm_Horizontal
Q401: 2N5457 S&H switch; TO-92_Inline
R401, R402, R403, R406, R411: 100k; R_Axial_L6.8mm_D2.5mm_P10.16mm
R404: 4k7; R_Axial_L6.8mm_D2.5mm_P10.16mm
R407: 1k2; R_Axial_L6.8mm_D2.5mm_P10.16mm
R408: 1M; R_Axial_L6.8mm_D2.5mm_P10.16mm
R409: 2k2; R_Axial_L6.8mm_D2.5mm_P10.16mm
R410: 22k; R_Axial_L6.8mm_D2.5mm_P10.16mm
R412: 300k LOOP CAL; R_Axial_L6.8mm_D2.5mm_P10.16mm
R413: 100; R_Axial_L6.8mm_D2.5mm_P10.16mm
R414, R415: 50k 1%; R_Axial_L6.8mm_D2.5mm_P10.16mm
RV401: 100k LIN wet blend (provisional); Potentiometer_RV09_ExplodingShed_101018
RV402: 2x50k LIN CHARACTER; Potentiometer_Alpha_RD902F-40-00D_Dual_Vertical
RV403: 10k DRIVE TRIM; Trimmer_Nidec_CT-6EP
RV404: 10k LIN AMOUNT; Potentiometer_RV09_ExplodingShed_101018
U401, U402: TL072; DIP-8_W7.62mm_Socket

Connections:
+5V: R401.1; also elsewhere on the board
+12V: C407.1, C409.1, U401.8 (V+), U402.8 (V+); also elsewhere on the board
-12V: C408.1, C410.1, U401.4 (V-), U402.4 (V-); also elsewhere on the board
/Wet and S&H/HOLD: C403.1, Q401.2 (S), U402.5 (+)
/Wet and S&H/Q401_GATE: D401.2 (A), Q401.3 (G), R403.2
/Wet and S&H/SH_IN: C401.1, Q401.1 (D), R401.2, R402.1, R403.1
/Wet and S&H/TRIGGER: C402.2, D401.1 (K), R404.1
BBD1_SUM: RV401.1; also elsewhere on the board
BBD2_SUM: RV401.3; also elsewhere on the board
BBD_CP1: C402.1; also elsewhere on the board
FEEDBACK_RETURN: R412.1, U401.7; also elsewhere on the board
GND: C403.2, C405.2, C407.2, C408.2, C409.2, C410.2, R402.2, R404.2, R406.2, R408.2, R415.2, RV402.6, RV404.3, U401.5 (+); also elsewhere on the board
unnamed: C401.2, R413.2
unnamed: C406.1, RV404.2
unnamed: C406.2, R411.1
unnamed: D402.2 (A), D403.1 (K), R409.1, R410.2, U401.2 (-)
unnamed: D402.1 (K), D403.2 (A), R410.1, RV404.1, U401.1
unnamed: R407.2, R414.1, RV402.1
unnamed: R409.2, RV403.1
unnamed: R415.1, RV402.4, RV402.5, RV403.2, RV403.3
unnamed: C405.1, R408.1, R414.2, RV402.2, RV402.3, U401.3 (+)
unnamed: R411.2, R412.2, U401.6 (-)
unnamed: R413.1, U402.1, U402.2 (-)
unnamed: C404.1, U402.6 (-), U402.7
OUT_SH: C404.2, R406.1, R407.1; also elsewhere on the board
WET_MIX: RV401.2, U402.3 (+); also elsewhere on the board

Notes on the sheet:
Internal trim: start ~800 ohm. Nominal 0.5Vpp/440Hz: 90% ~12.9% THD, max ~19.1%.
U401A: non-inverting character drive; U401B: inverting return. FEEDBACK: pre-filter -> drive -> AMOUNT -> return.
Return gain -3.0: R412/R411. Front summer -47k/100k feedback; resistor calibration in module completion note.
U402A: wet buffer unity follower; U402B: HOLD unity follower driving C404.
RV402A + RV402B = one dual-gang CHARACTER shaft
RV402: dual B50k, opposite rheostats; R414/R415 shunt each gang to nominal 0-25k. Curved sweep.
Shared S&H remains device-dependent; input/output loop is connected. Simulations are not bench qualification.

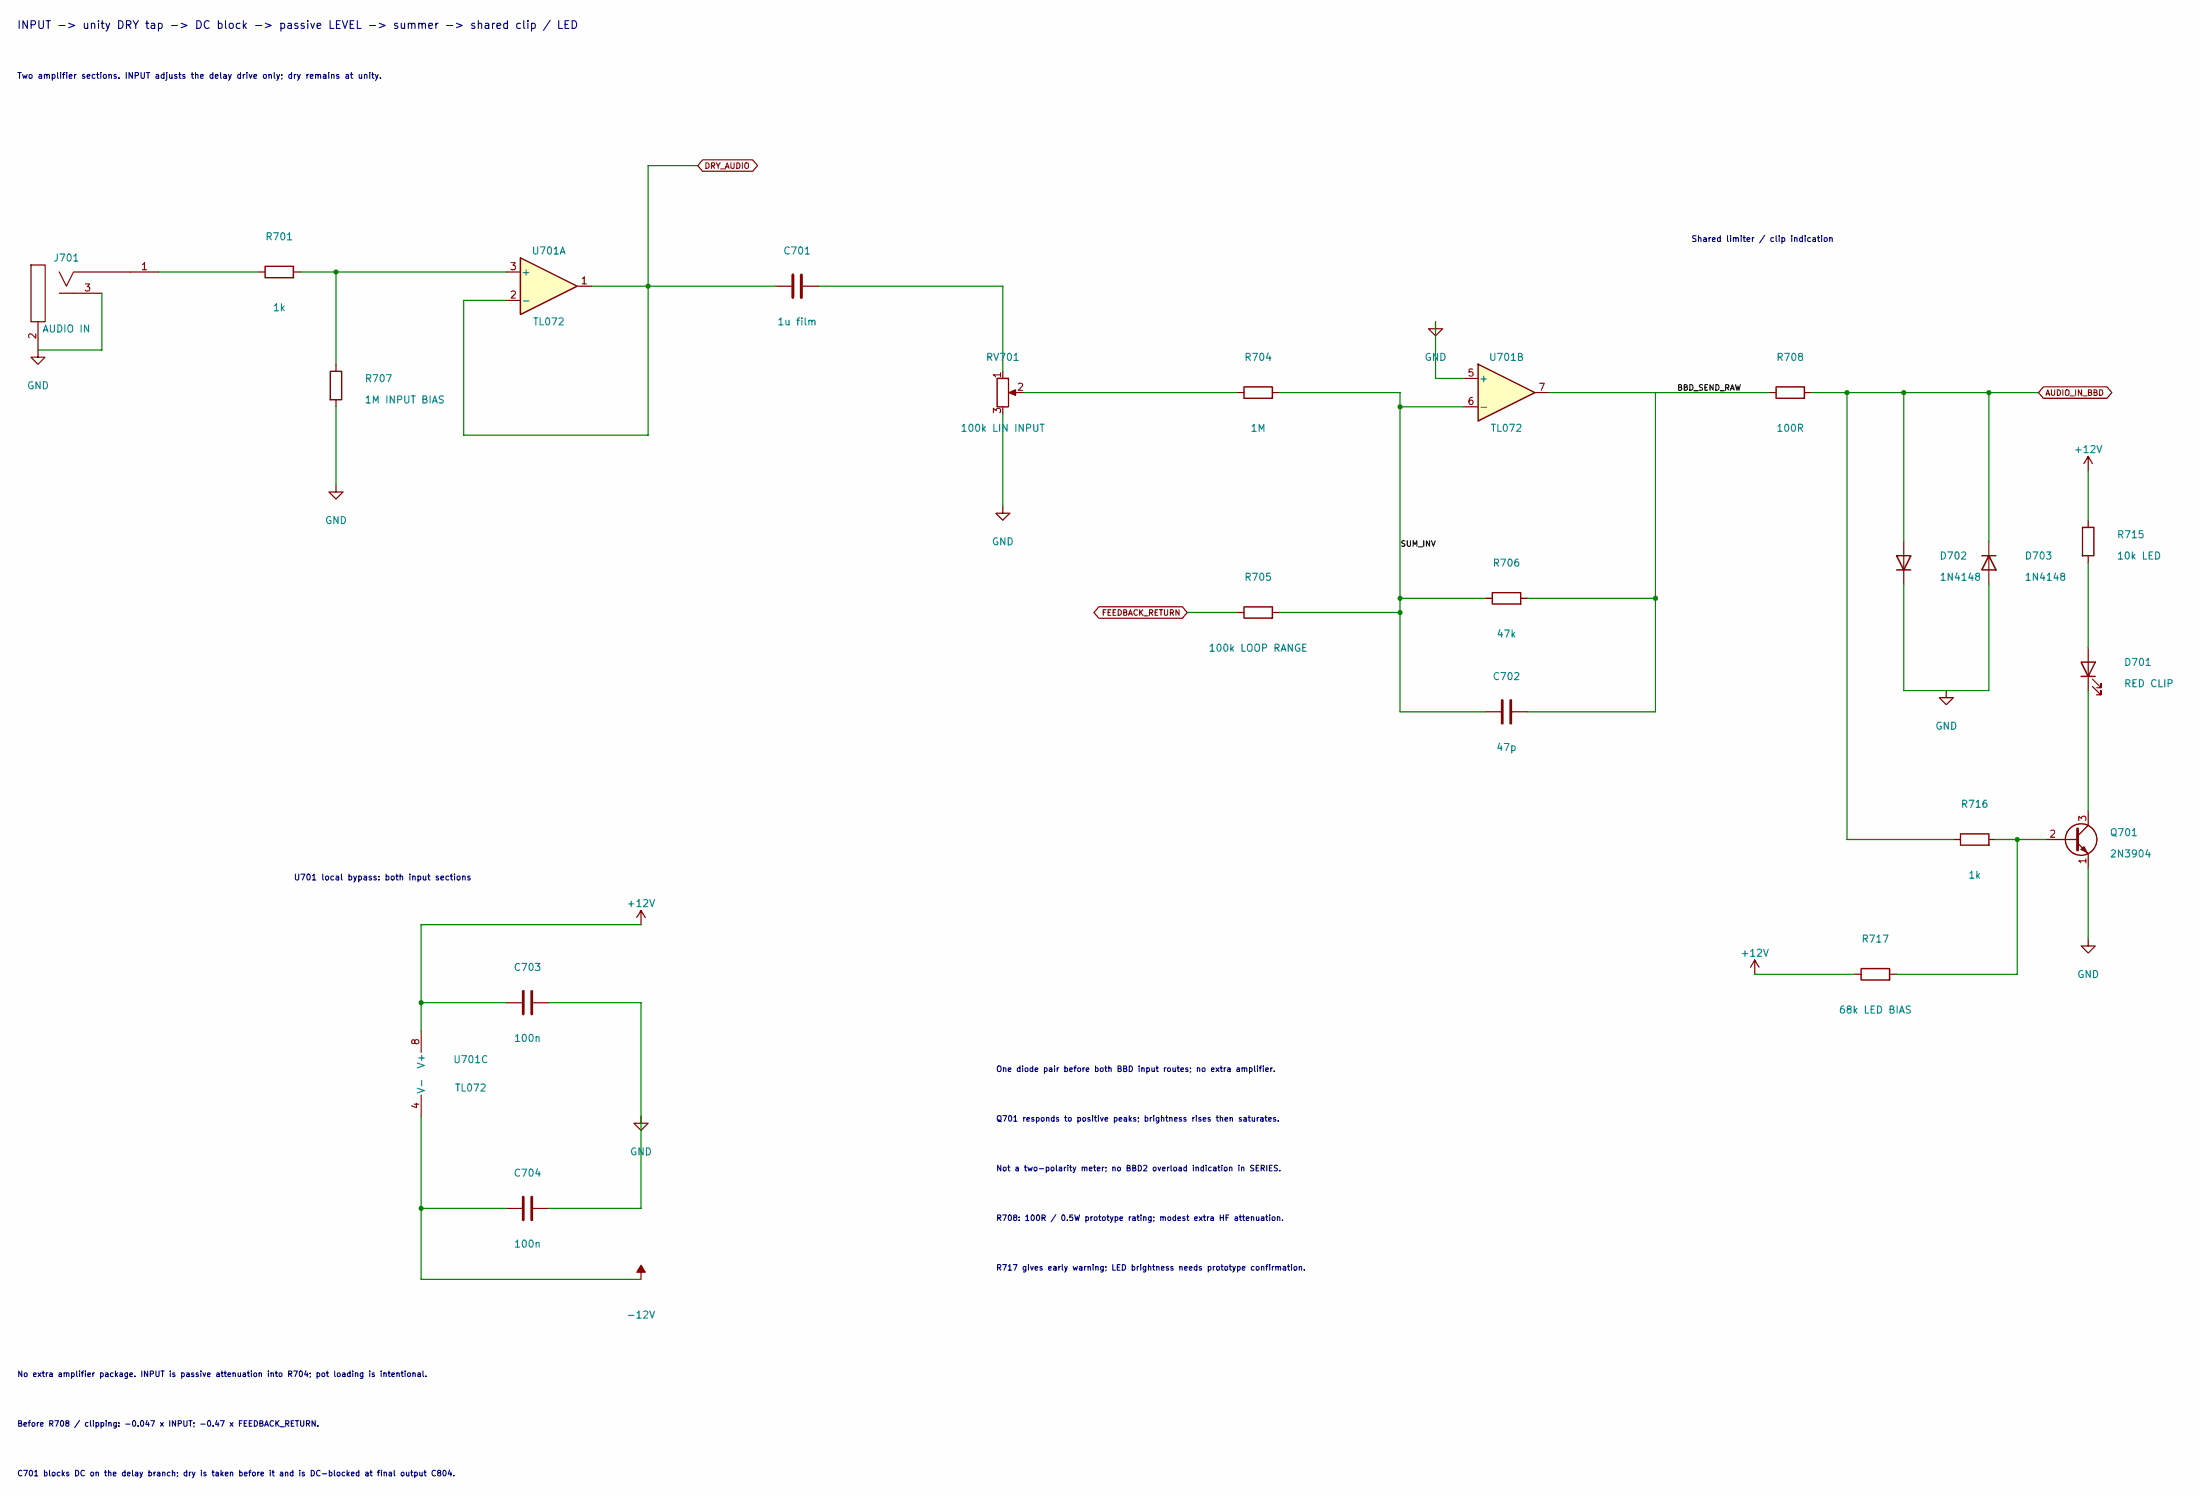
[picture p13: schematic Input_IO.kicad_sch, ZanGei - input, feedback sum and shared clip / LED]

Parts:
C701: 1u film; C_Rect_L7.2mm_W6.0mm_P5.00mm
C702: 47p; C_Radial_KEMET_C315_P2.54_Body3.81x5.0
C703, C704: 100n; C_KEMET_C315C104_P2.54_L3.81_W2.54; MPN C315C104K5R5TA
D701: RED CLIP; LED_D3.0mm; MPN WP3A8ID
D702, D703: 1N4148; D_DO-35_SOD27_P7.62mm_Horizontal
J701: AUDIO IN; Jack_WQP518MA_PJ398SM_Numeric
Q701: 2N3904; TO-92_Inline
R701, R716: 1k; R_Axial_L6.8mm_D2.5mm_P10.16mm
R704: 1M; R_Axial_L6.8mm_D2.5mm_P10.16mm
R705: 100k LOOP RANGE; R_Axial_L6.8mm_D2.5mm_P10.16mm
R706: 47k; R_Axial_L6.8mm_D2.5mm_P10.16mm
R707: 1M INPUT BIAS; R_Axial_L6.8mm_D2.5mm_P10.16mm
R708: 100R; R_Axial_L6.8mm_D2.5mm_P10.16mm
R715: 10k LED; R_Axial_L6.8mm_D2.5mm_P10.16mm
R717: 68k LED BIAS; R_Axial_L6.8mm_D2.5mm_P10.16mm
RV701: 100k LIN INPUT; Potentiometer_RV09_ExplodingShed_101018
U701: TL072; DIP-8_W7.62mm_Socket

Connections:
+12V: C703.1, R715.1, R717.1, U701.8 (V+); also elsewhere on the board
-12V: C704.1, U701.4 (V-); also elsewhere on the board
/Input, feedback sum and clip LED/BBD_SEND_RAW: C702.2, R706.2, R708.1, U701.7
/Input, feedback sum and clip LED/SUM_INV: C702.1, R704.2, R705.2, R706.1, U701.6 (-)
AUDIO_IN_BBD: D702.2 (A), D703.1 (K), R708.2, R716.1; also elsewhere on the board
DRY_AUDIO: C701.1, U701.1, U701.2 (-); also elsewhere on the board
FEEDBACK_RETURN: R705.1; also elsewhere on the board
GND: C703.2, C704.2, D702.1 (K), D703.2 (A), J701.2 (SHEILD), J701.3 (SW), Q701.1 (E), R707.2, RV701.3, U701.5 (+); also elsewhere on the board
unnamed: C701.2, RV701.1
unnamed: D701.2 (A), R715.2
unnamed: D701.1 (K), Q701.3 (C)
unnamed: J701.1 (SIG), R701.1
unnamed: Q701.2 (B), R716.2, R717.2
unnamed: R704.1, RV701.2
unnamed: R701.2, R707.1, U701.3 (+)

Notes on the sheet:
One diode pair before both BBD input routes; no extra amplifier.
C701 blocks DC on the delay branch; dry is taken before it and is DC-blocked at final output C804.
R717 gives early warning; LED brightness needs prototype confirmation.
R708: 100R / 0.5W prototype rating; modest extra HF attenuation.
U701 local bypass: both input sections
Before R708 / clipping: -0.047 x INPUT; -0.47 x FEEDBACK_RETURN.
No extra amplifier package. INPUT is passive attenuation into R704; pot loading is intentional.
Shared limiter / clip indication
Q701 responds to positive peaks; brightness rises then saturates.
Not a two-polarity meter; no BBD2 overload indication in SERIES.
INPUT -> unity DRY tap -> DC block -> passive LEVEL -> summer -> shared clip / LED
Two amplifier sections. INPUT adjusts the delay drive only; dry remains at unity.
