plotneishestvo/ZanGei/schematics/BBD_Buffer.kicad_pcb

## KiCad design schematics/BBD_Buffer.kicad_pcb (continued)

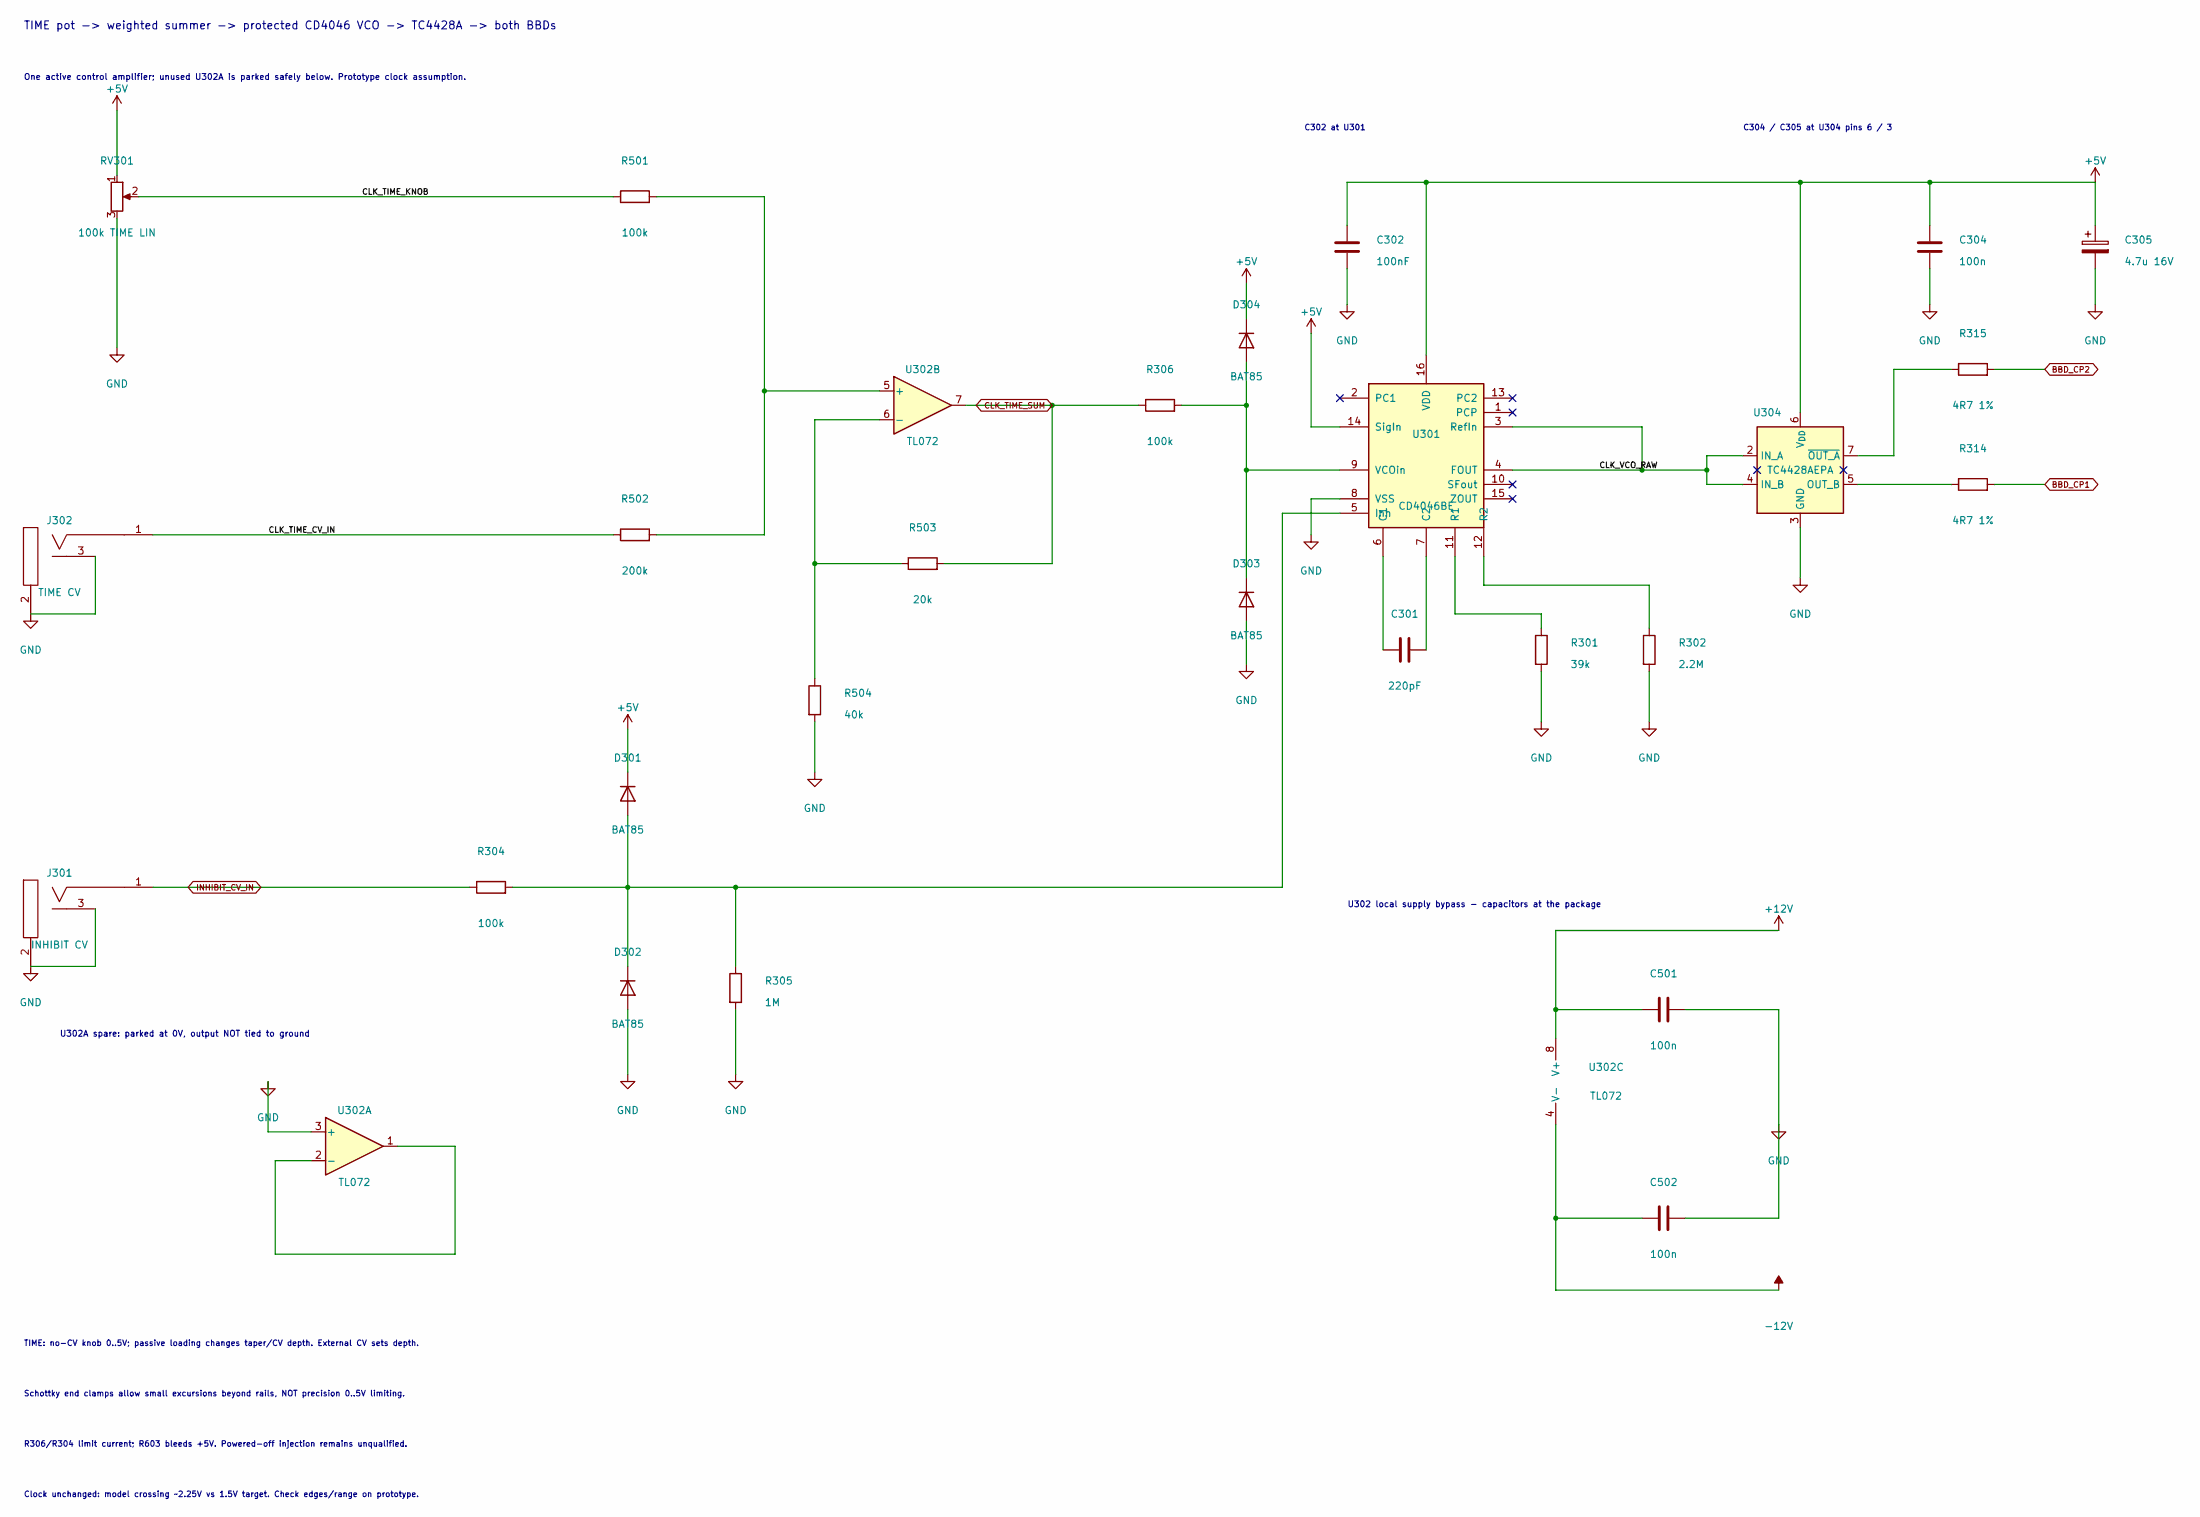
[picture p14: schematic Clock_CV.kicad_sch, ZanGei - full-range TIME plus additive CV]

Parts:
C301: 220pF; C_Radial_KEMET_C315_P2.54_Body3.81x5.0
C302: 100nF; C_KEMET_C315C104_P2.54_L3.81_W2.54; MPN C315C104K5R5TA
C304, C501, C502: 100n; C_KEMET_C315C104_P2.54_L3.81_W2.54; MPN C315C104K5R5TA
C305: 4.7u 16V; CP_Radial_D5_H11_P2.00_NoModel
D301, D302, D303, D304: BAT85; D_DO-34_SOD68_P7.62mm_Horizontal
J301: INHIBIT CV; Jack_WQP518MA_PJ398SM_Numeric
J302: TIME CV; Jack_WQP518MA_PJ398SM_Numeric
R301: 39k; R_Axial_L6.8mm_D2.5mm_P10.16mm
R302: 2.2M; R_Axial_L9.25mm_D3.6mm_P12.70mm
R304, R306, R501: 100k; R_Axial_L6.8mm_D2.5mm_P10.16mm
R305: 1M; R_Axial_L6.8mm_D2.5mm_P10.16mm
R314, R315: 4R7 1%; R_Axial_L6.8mm_D2.5mm_P10.16mm
R502: 200k; R_Axial_L6.8mm_D2.5mm_P10.16mm
R503: 20k; R_Axial_L6.8mm_D2.5mm_P10.16mm
R504: 40k; R_Axial_L6.8mm_D2.5mm_P10.16mm
RV301: 100k TIME LIN; Potentiometer_RV09_ExplodingShed_101018
U301: CD4046BE; DIP-16_W7.62mm_Socket
U302: TL072; DIP-8_W7.62mm_Socket
U304: TC4428AEPA; DIP-8_W7.62mm_Socket

Connections:
+5V: C302.1, C304.1, C305.1, D301.1 (K), D304.1 (K), RV301.1, U301.14 (SigIn), U301.16 (VDD), U304.6 (V_{DD}); also elsewhere on the board
+12V: C501.1, U302.8 (V+); also elsewhere on the board
-12V: C502.1, U302.4 (V-); also elsewhere on the board
/Clock and CV/CLK_TIME_CV_IN: J302.1 (SIG), R502.1
/Clock and CV/CLK_TIME_KNOB: R501.1, RV301.2
/Clock and CV/CLK_VCO_RAW: U301.3 (RefIn), U301.4 (FOUT), U304.2 (IN_A), U304.4 (IN_B)
BBD_CP1: R314.2; also elsewhere on the board
BBD_CP2: R315.2; also elsewhere on the board
CLK_TIME_SUM: R306.1, R503.2, U302.7; also elsewhere on the board
GND: C302.2, C304.2, C305.2, C501.2, C502.2, D302.2 (A), D303.2 (A), J301.2 (SHEILD), J301.3 (SW), J302.2 (SHEILD), J302.3 (SW), R301.2, R302.2, R305.2, R504.2, RV301.3, U301.8 (VSS), U302.3 (+), U304.3 (GND); also elsewhere on the board
INHIBIT_CV_IN: J301.1 (SIG), R304.1; also elsewhere on the board
unnamed: D301.2 (A), D302.1 (K), R304.2, R305.1, U301.5 (Inh)
unnamed: D303.1 (K), D304.2 (A), R306.2, U301.9 (VCOin)
unnamed: C301.1, U301.6 (C1)
unnamed: C301.2, U301.7 (C2)
unnamed: R301.1, U301.11 (R1)
unnamed: R302.1, U301.12 (R2)
unnamed: U302.1, U302.2 (-)
unnamed: R501.2, R502.2, U302.5 (+)
unnamed: R503.1, R504.1, U302.6 (-)
unnamed: R314.1, U304.5 (OUT_B)
unnamed: R315.1, U304.7 (~OUT_A)

Notes on the sheet:
Clock unchanged: model crossing ~2.25V vs 1.5V target. Check edges/range on prototype.
U302A spare: parked at 0V, output NOT tied to ground
R306/R304 limit current; R603 bleeds +5V. Powered-off injection remains unqualified.
TIME: no-CV knob 0..5V; passive loading changes taper/CV depth. External CV sets depth.
TIME pot -> weighted summer -> protected CD4046 VCO -> TC4428A -> both BBDs
C304 / C305 at U304 pins 6 / 3
One active control amplifier; unused U302A is parked safely below. Prototype clock assumption.
U302 local supply bypass - capacitors at the package
C302 at U301
Schottky end clamps allow small excursions beyond rails, NOT precision 0..5V limiting.

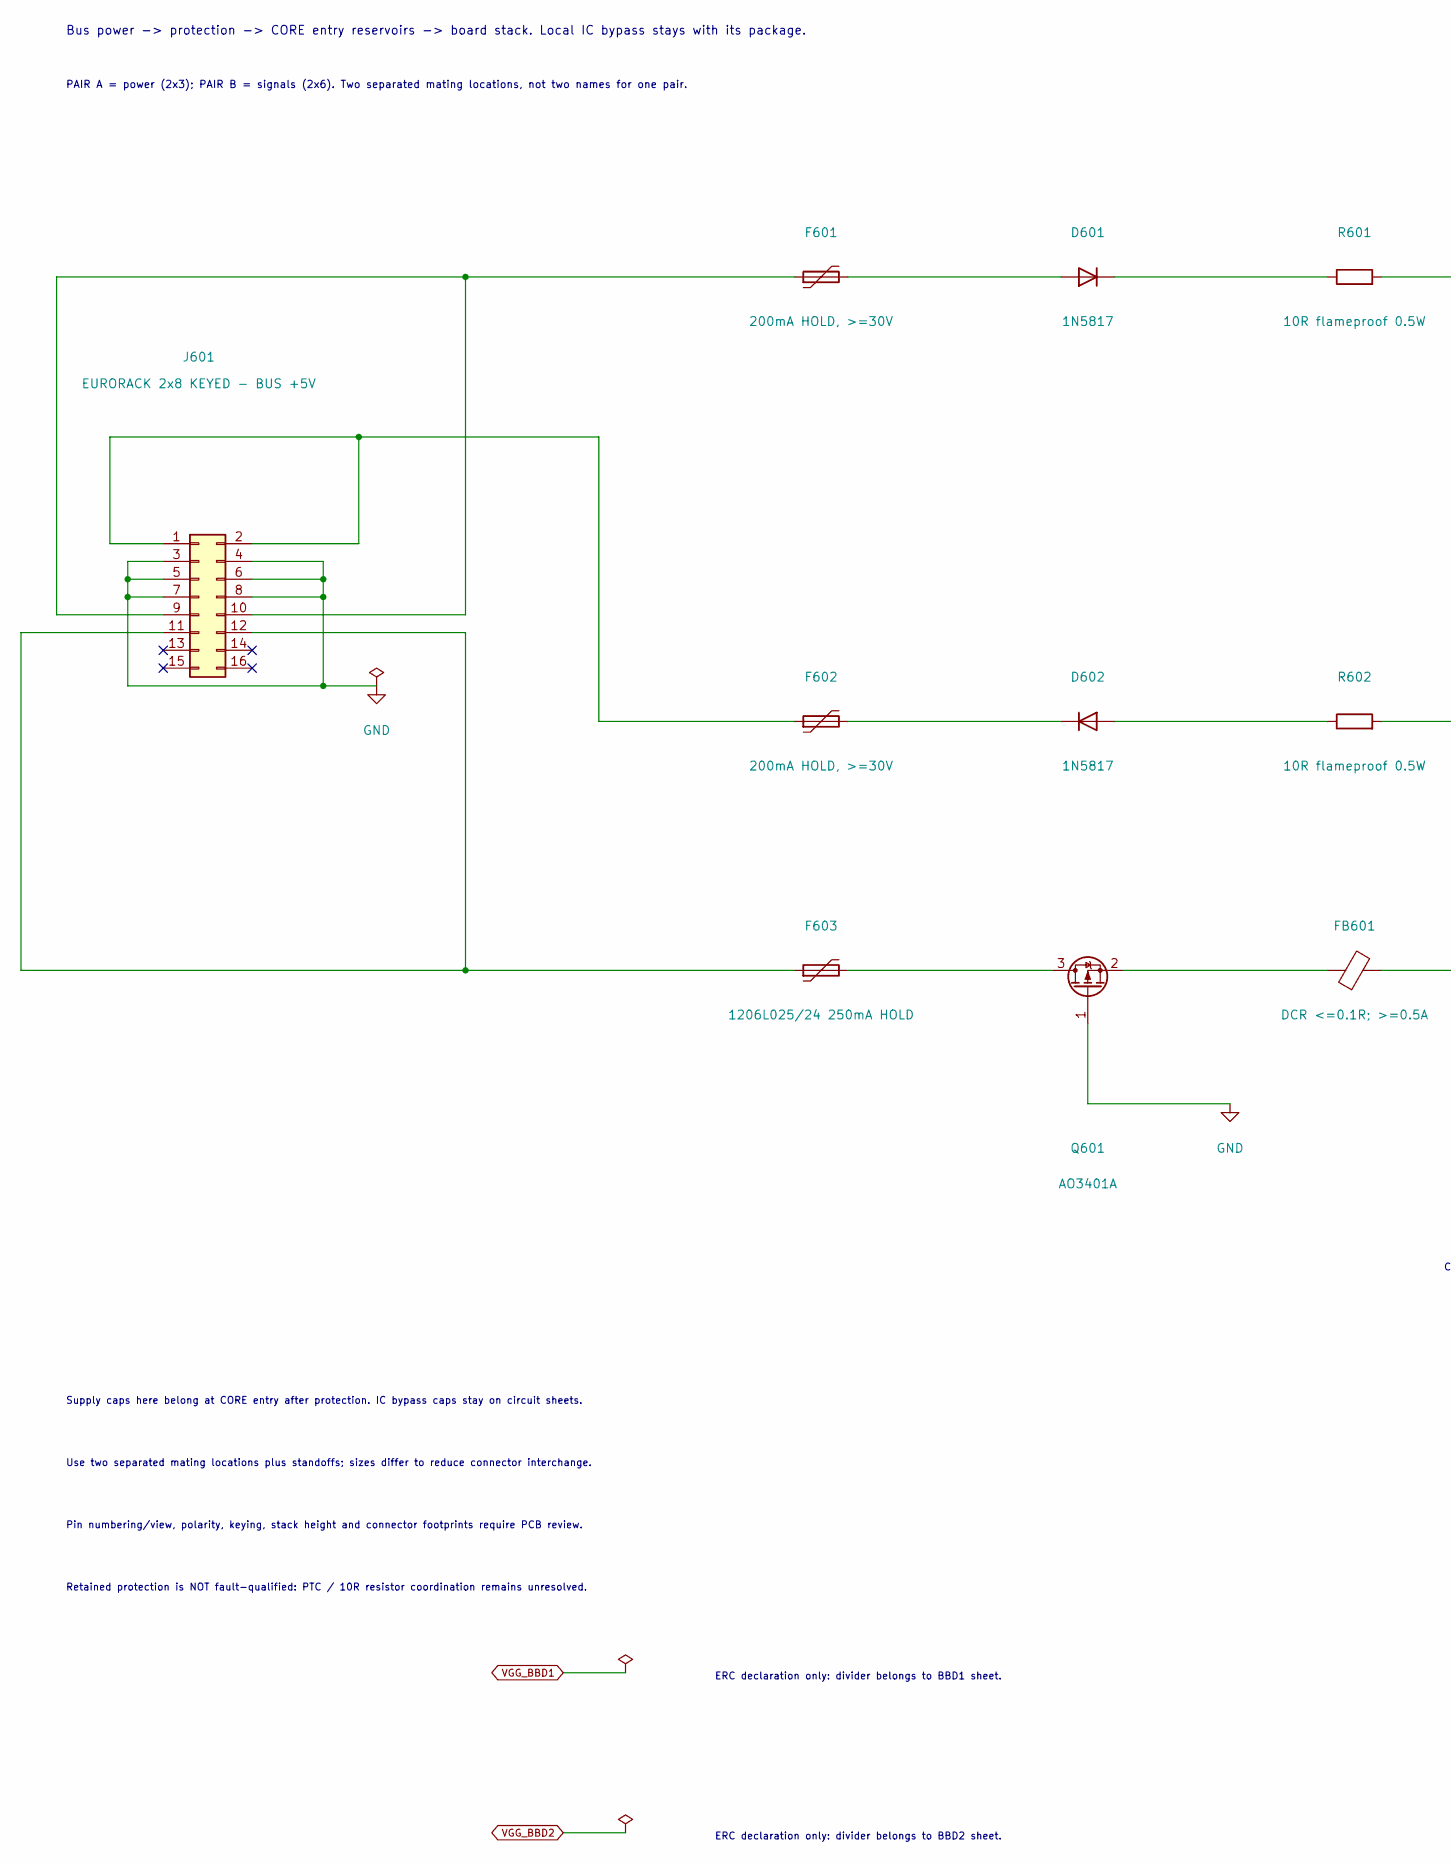
[picture p15: schematic Power_Stack.kicad_sch, ZanGei - power entry and two mating stack pairs, part in row 1, column 1]

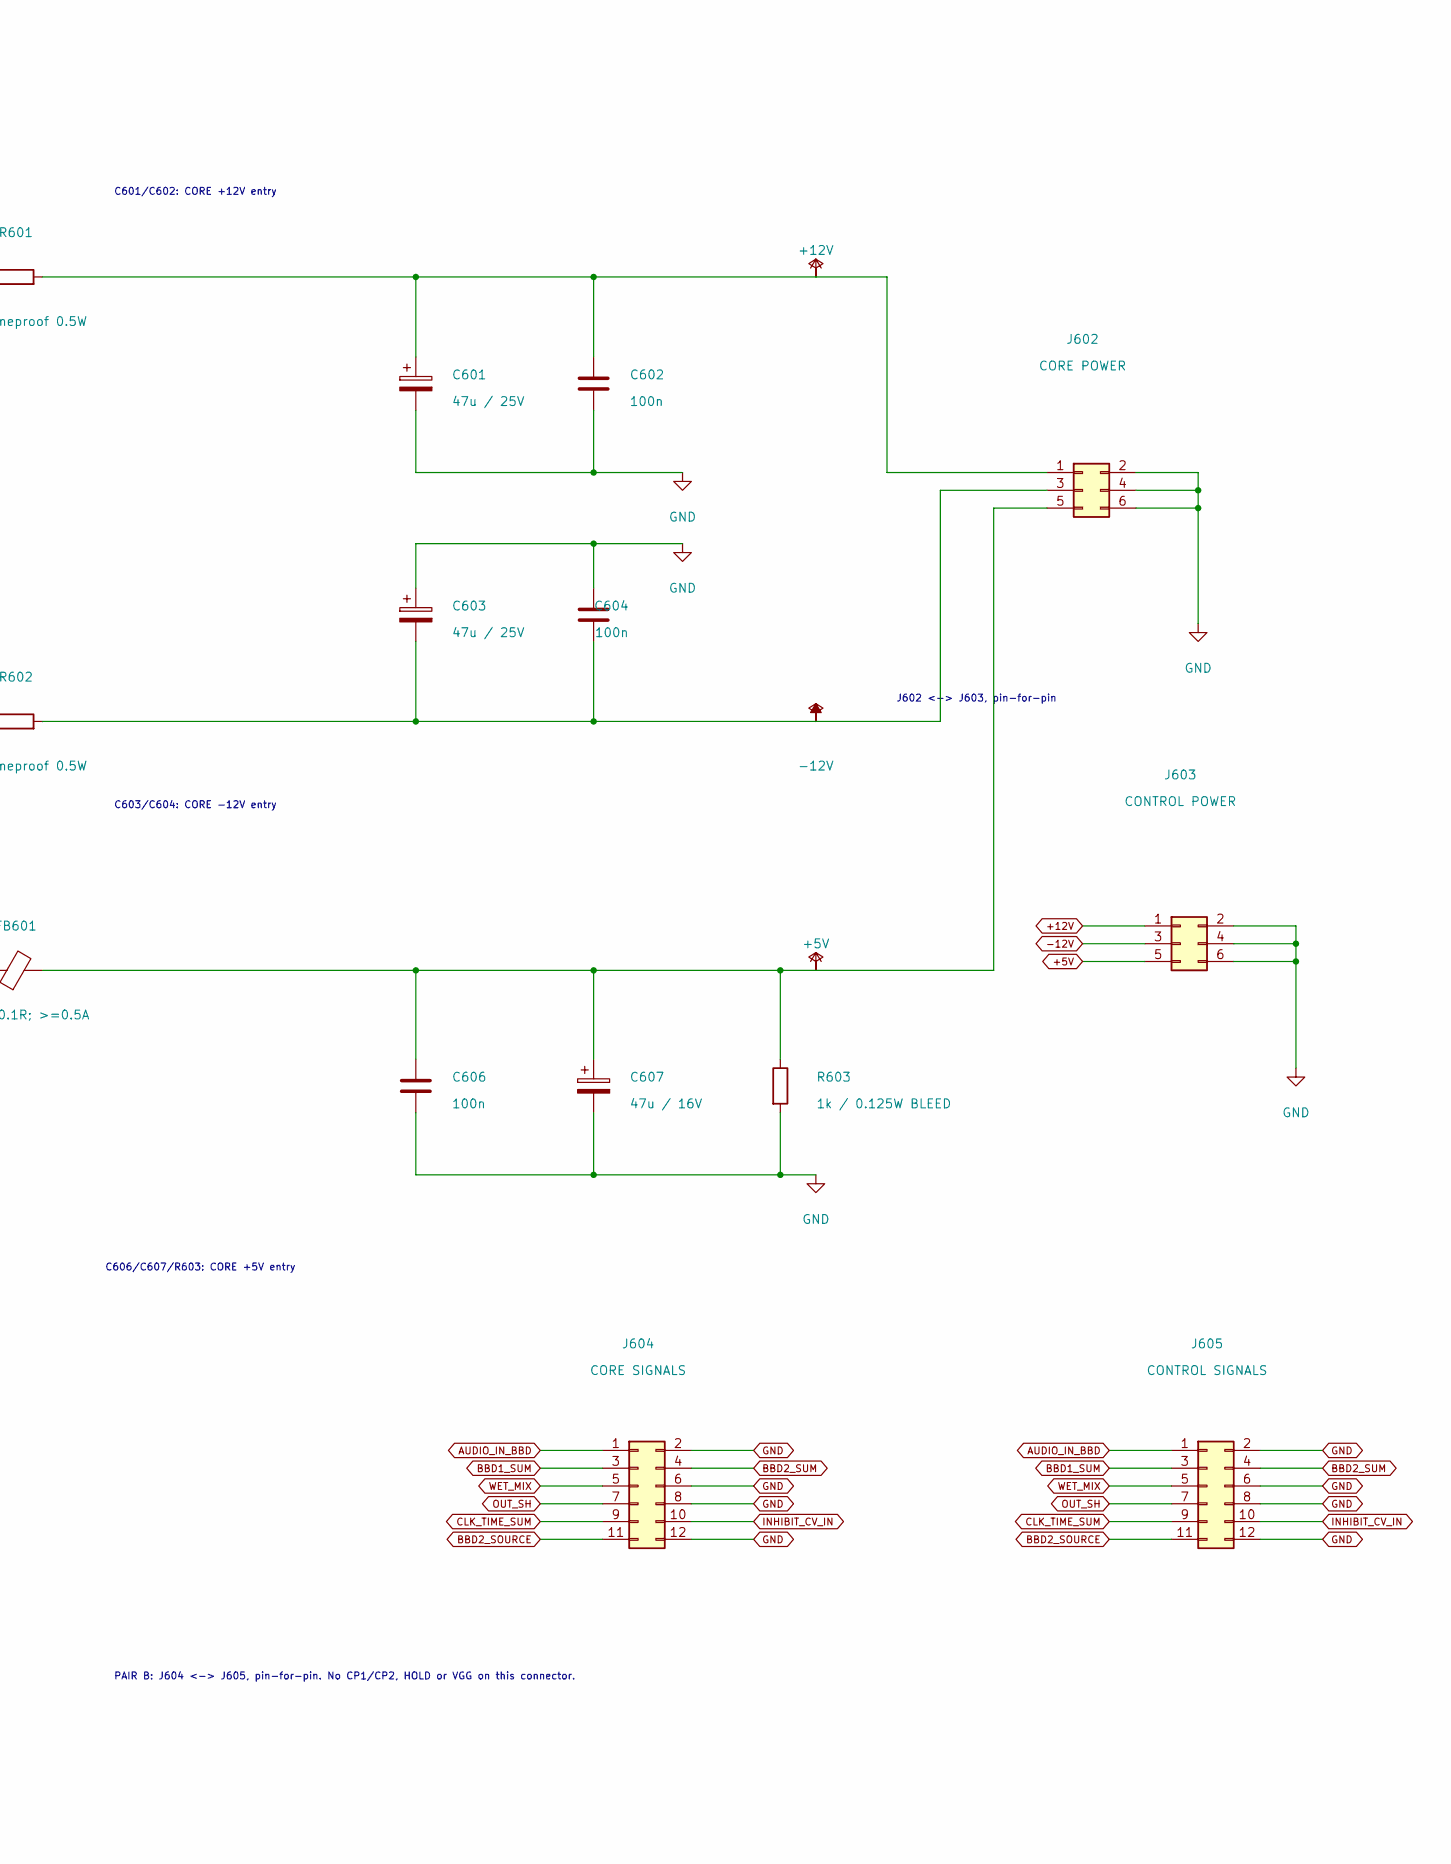
[picture p16: schematic Power_Stack.kicad_sch, ZanGei - power entry and two mating stack pairs, part in row 1, column 2]

Parts:
C601, C603: 47u / 25V; CP_Radial_D6.3mm_P2.50mm
C602, C604, C606: 100n; C_KEMET_C315C104_P2.54_L3.81_W2.54; MPN C315C104K5R5TA
C607: 47u / 16V; CP_Radial_D6.3mm_P2.50mm
D601, D602: 1N5817; D_DO-41_SOD81_P10.16mm_Horizontal
F601, F602: 200mA HOLD, >=30V; PTC_Bourns_MF-R020_P5.10; MPN MF-R020-2
F603: 1206L025/24 250mA HOLD; PTC_Littelfuse_1206L_ManufacturerLands; MPN 1206L025/24YR
FB601: DCR <=0.1R; >=0.5A; Ferrite_Murata_BLM31PG_Pads1.5x1.8_Gap2.0; MPN BLM31PG121SN1L
J601: EURORACK 2x8 KEYED - BUS +5V; IDC-Header_2x08_P2.54mm_Vertical
J602: CORE POWER; PinHeader_2x03_P2.54mm_Vertical
J603: CONTROL POWER; PinSocket_2x03_P2.54mm_Vertical
J604: CORE SIGNALS; PinHeader_2x06_P2.54mm_Vertical
J605: CONTROL SIGNALS; PinSocket_2x06_P2.54mm_Vertical
Q601: AO3401A; SOT-23-3
R601, R602: 10R flameproof 0.5W; R_Axial_L6.8mm_D2.5mm_P10.16mm; MPN NFR25H0001009JR500
R603: 1k / 0.125W BLEED; R_Axial_L6.8mm_D2.5mm_P10.16mm

Connections:
+5V: C606.1, C607.1, FB601.2, J602.5, J603.5, R603.1; also elsewhere on the board
+12V: C601.1, C602.1, J602.1, J603.1, R601.2; also elsewhere on the board
-12V: C603.2, C604.1, J602.3, J603.3, R602.2; also elsewhere on the board
AUDIO_IN_BBD: J604.1, J605.1; also elsewhere on the board
BBD1_SUM: J604.3, J605.3; also elsewhere on the board
BBD2_SOURCE: J604.11, J605.11; also elsewhere on the board
BBD2_SUM: J604.4, J605.4; also elsewhere on the board
CLK_TIME_SUM: J604.9, J605.9; also elsewhere on the board
GND: C601.2, C602.2, C603.1, C604.2, C606.2, C607.2, J601.3, J601.4, J601.5, J601.6, J601.7, J601.8, J602.2, J602.4, J602.6, J603.2, J603.4, J603.6, J604.2, J604.6, J604.8, J604.12, J605.2, J605.6, J605.8, J605.12, Q601.1 (G), R603.2; also elsewhere on the board
INHIBIT_CV_IN: J604.10, J605.10; also elsewhere on the board
unnamed: D601.2 (A), F601.2
unnamed: D601.1 (K), R601.1
unnamed: D602.2 (A), R602.1
unnamed: D602.1 (K), F602.2
unnamed: F602.1, J601.1, J601.2
unnamed: F601.1, J601.9, J601.10
unnamed: F603.1, J601.11, J601.12
unnamed: F603.2, Q601.3 (D)
unnamed: FB601.1, Q601.2 (S)
OUT_SH: J604.7, J605.7; also elsewhere on the board
WET_MIX: J604.5, J605.5; also elsewhere on the board

Notes on the sheet:
Pin numbering/view, polarity, keying, stack height and connector footprints require PCB review.
C606/C607/R603: CORE +5V entry
ERC declaration only: divider belongs to BBD1 sheet.
Supply caps here belong at CORE entry after protection. IC bypass caps stay on circuit sheets.
PAIR B: J604 <-> J605, pin-for-pin. No CP1/CP2, HOLD or VGG on this connector.
PAIR A = power (2x3); PAIR B = signals (2x6). Two separated mating locations, not two names for one pair.
ERC declaration only: divider belongs to BBD2 sheet.
J602 <-> J603, pin-for-pin
Retained protection is NOT fault-qualified: PTC / 10R resistor coordination remains unresolved.
C601/C602: CORE +12V entry
C603/C604: CORE -12V entry
Use two separated mating locations plus standoffs; sizes differ to reduce connector interchange.
Bus power -> protection -> CORE entry reservoirs -> board stack. Local IC bypass stays with its package.

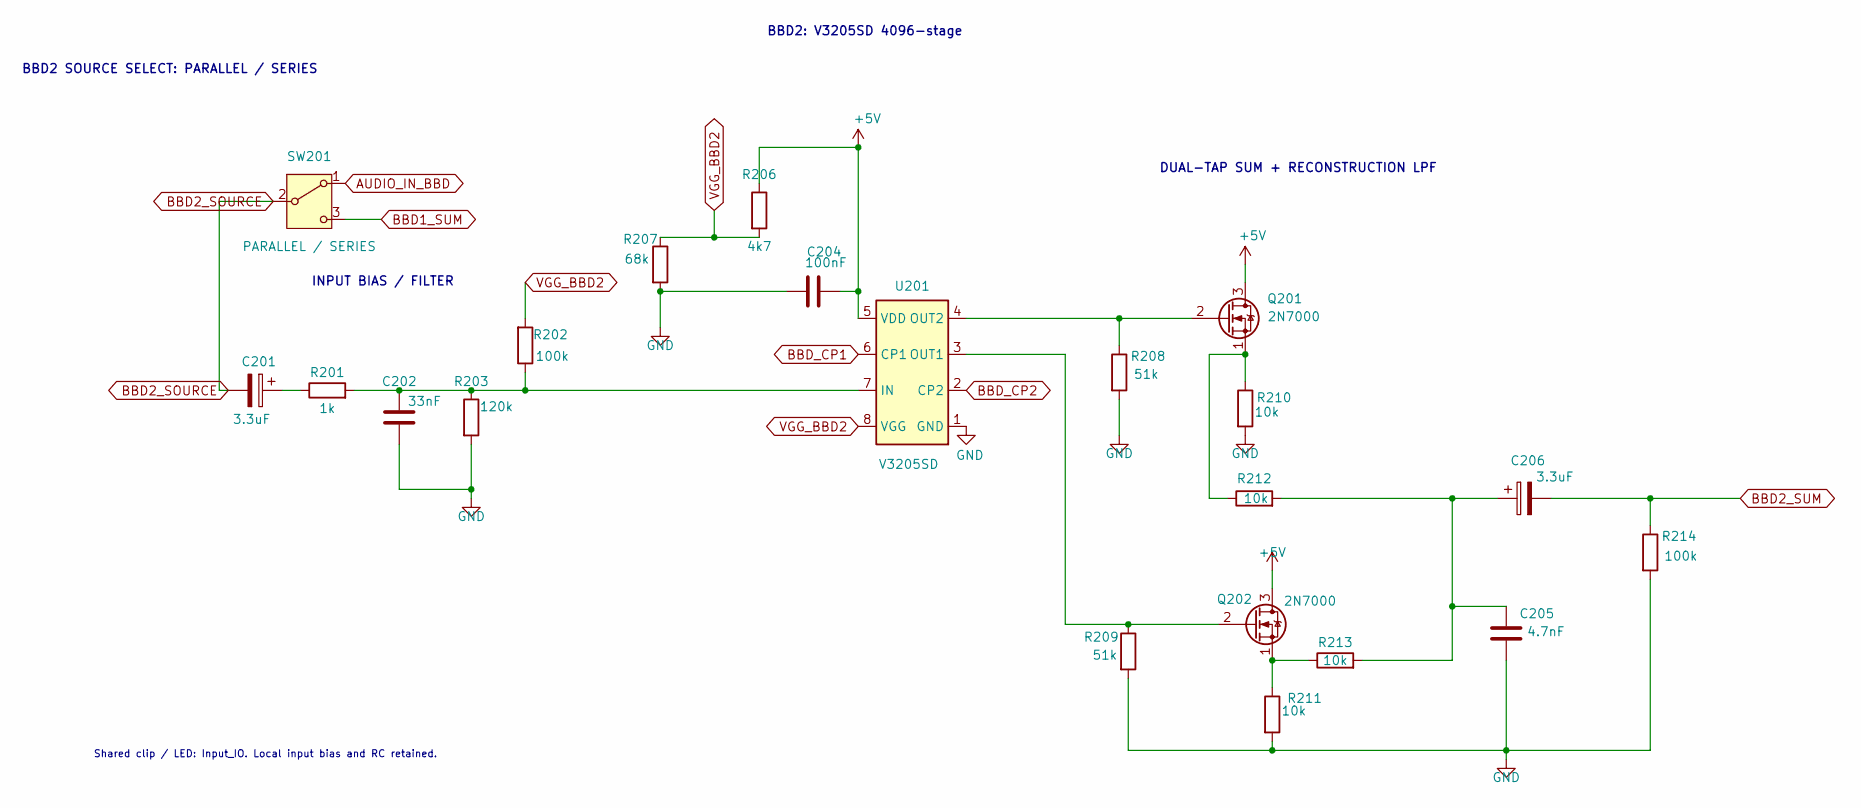
[picture p17: schematic BBD2_V3205.kicad_sch, Zangei BBD2 V3205SD]

Parts:
C201, C206: 3.3uF; CP_Radial_D5.0mm_P2.50mm
C202: 33nF; C_Rect_L7.2mm_W2.5mm_P5.00mm
C204: 100nF; C_KEMET_C315C104_P2.54_L3.81_W2.54; MPN C315C104K5R5TA
C205: 4.7nF; C_Rect_L7.2mm_W2.5mm_P5.00mm
Q201, Q202: 2N7000; TO-92_Inline
R201: 1k; R_Axial_L6.8mm_D2.5mm_P10.16mm
R202, R214: 100k; R_Axial_L6.8mm_D2.5mm_P10.16mm
R203: 120k; R_Axial_L6.8mm_D2.5mm_P10.16mm
R206: 4k7; R_Axial_L6.8mm_D2.5mm_P10.16mm
R207: 68k; R_Axial_L6.8mm_D2.5mm_P10.16mm
R208, R209: 51k; R_Axial_L6.8mm_D2.5mm_P10.16mm
R210, R211, R212, R213: 10k; R_Axial_L6.8mm_D2.5mm_P10.16mm
SW201: PARALLEL / SERIES; Switch_Salecom_SKS_SP_Straight
U201: V3205SD; V3205SD_DIP16_Socket_LogicalPads

Connections:
+5V: C204.1, Q201.3 (D), Q202.3 (D), R206.1, U201.5 (VDD); also elsewhere on the board
AUDIO_IN_BBD: SW201.1 (A); also elsewhere on the board
BBD1_SUM: SW201.3 (C); also elsewhere on the board
BBD2_SOURCE: C201.2, SW201.2 (B); also elsewhere on the board
BBD2_SUM: C206.2, R214.1; also elsewhere on the board
BBD_CP1: U201.6 (CP1); also elsewhere on the board
BBD_CP2: U201.2 (CP2); also elsewhere on the board
GND: C202.2, C204.2, C205.2, R203.2, R207.2, R208.2, R209.2, R210.2, R211.2, R214.2, U201.1 (GND); also elsewhere on the board
unnamed: C201.1, R201.1
unnamed: C205.1, C206.1, R212.2, R213.2
unnamed: Q201.2 (G), R208.1, U201.4 (OUT2)
unnamed: Q201.1 (S), R210.1, R212.1
unnamed: Q202.2 (G), R209.1, U201.3 (OUT1)
unnamed: Q202.1 (S), R211.1, R213.1
unnamed: C202.1, R201.2, R202.1, R203.1, U201.7 (IN)
VGG_BBD2: R202.2, R206.2, R207.1, U201.8 (VGG)

Notes on the sheet:
DUAL-TAP SUM + RECONSTRUCTION LPF
Shared clip / LED: Input_IO. Local input bias and RC retained.
BBD2 SOURCE SELECT: PARALLEL / SERIES
INPUT BIAS / FILTER
BBD2: V3205SD 4096-stage

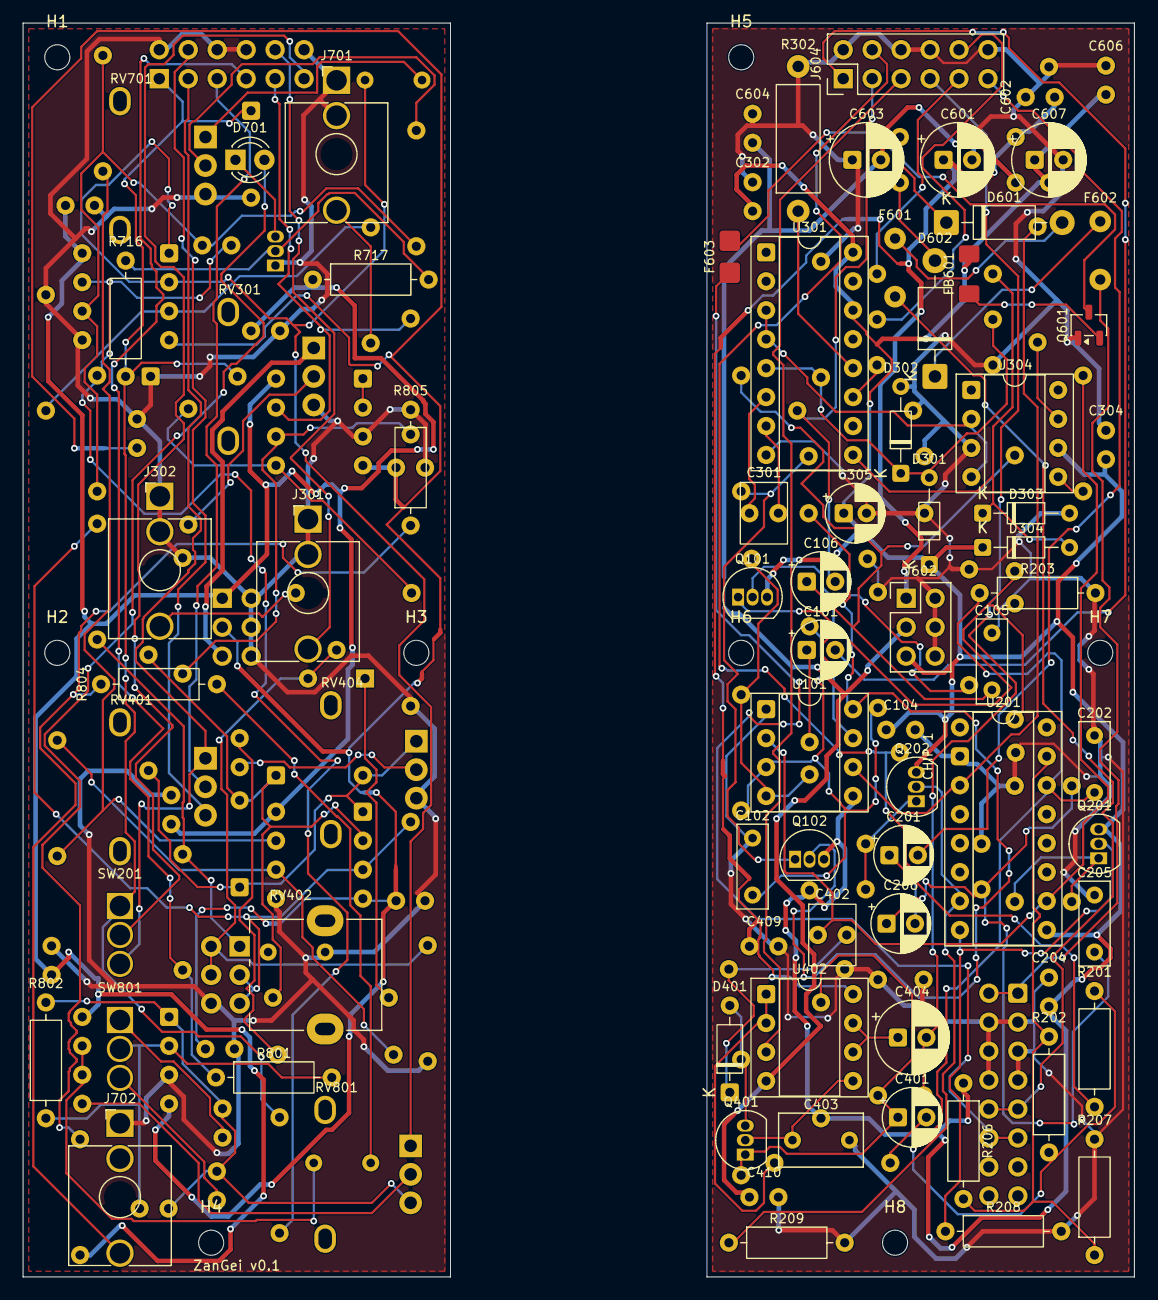
[picture p18: board BBD_Buffer.kicad_pcb from above]

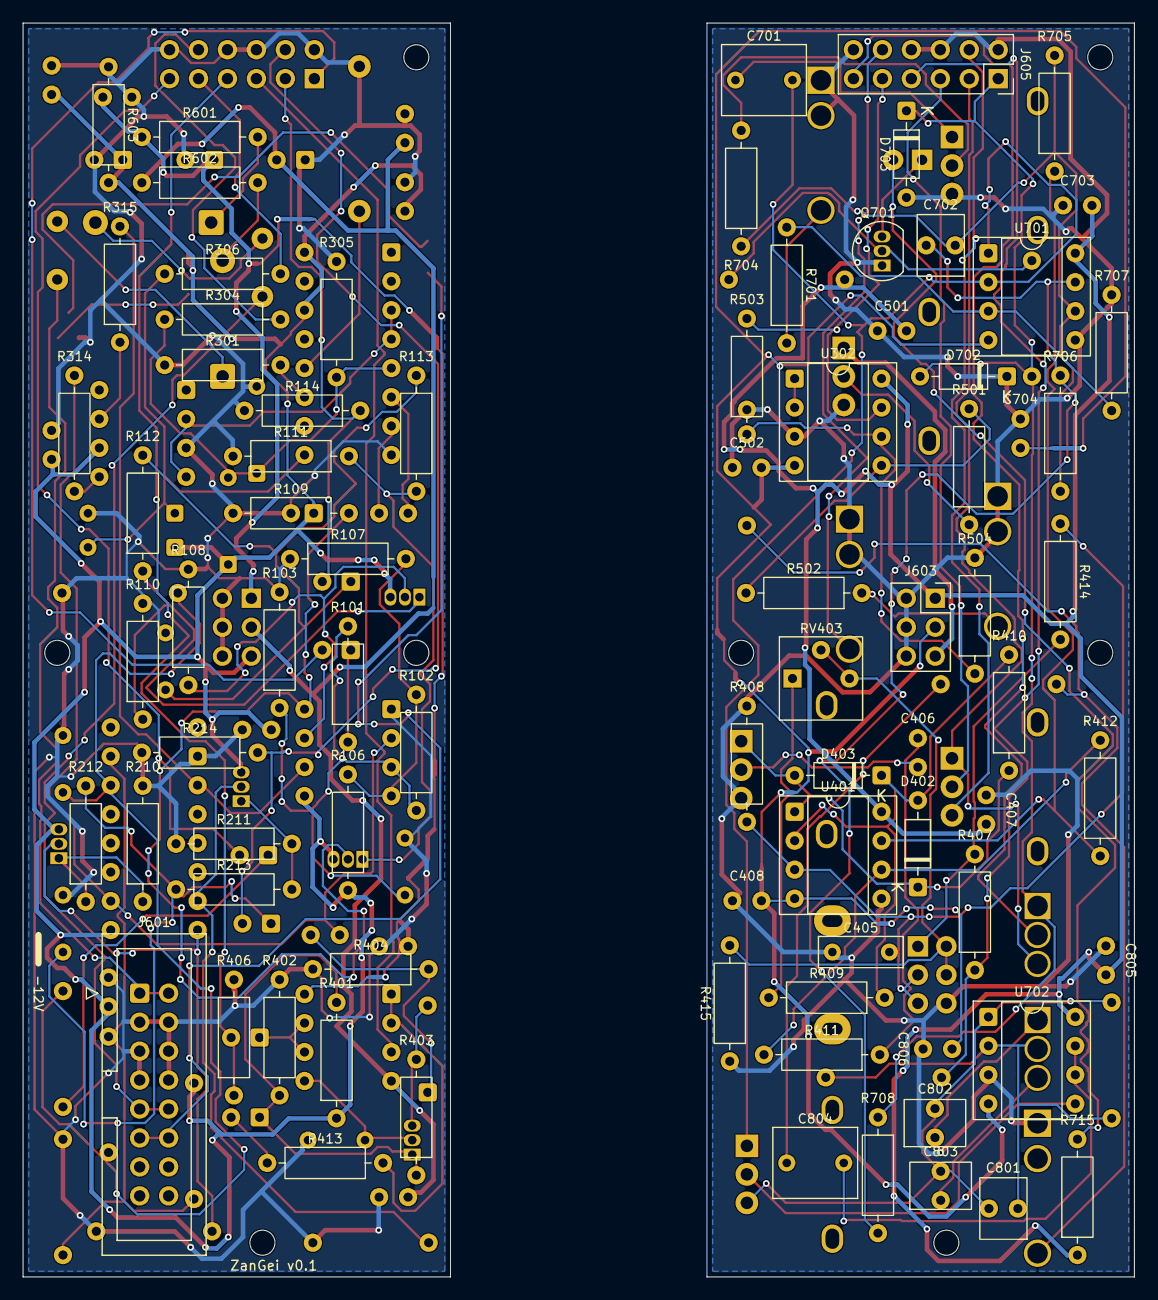
[picture p19: board BBD_Buffer.kicad_pcb from below]

Board: 2 copper layers, 97.5 x 110.0 mm, 165 parts (80 on the bottom side), 88 nets.

Other parts of the board:
H1, H2, H3, H4, H5, H6, H7, H8: MountingHole_2.2mm_M2
