plotneishestvo/ZanGei/(commit log)

2026-11-02 initial repo from private copy v0.1
    [BBD1_V3208.kicad_sch, BBD2_V3205.kicad_sch, BBD_Buffer.kicad_pcb, BBD_Buffer.kicad_sch, BOM_GROUPED.csv, BOM_PER_REFERENCE.csv, Clock_CV.kicad_sch, Input_IO.kicad_sch]
2026-11-02 Add pcb images
